c3ll256/rp-compute/product/gallery/420c5500-d6d6-4f90-9bab-eb5ddc3c4137.jpg

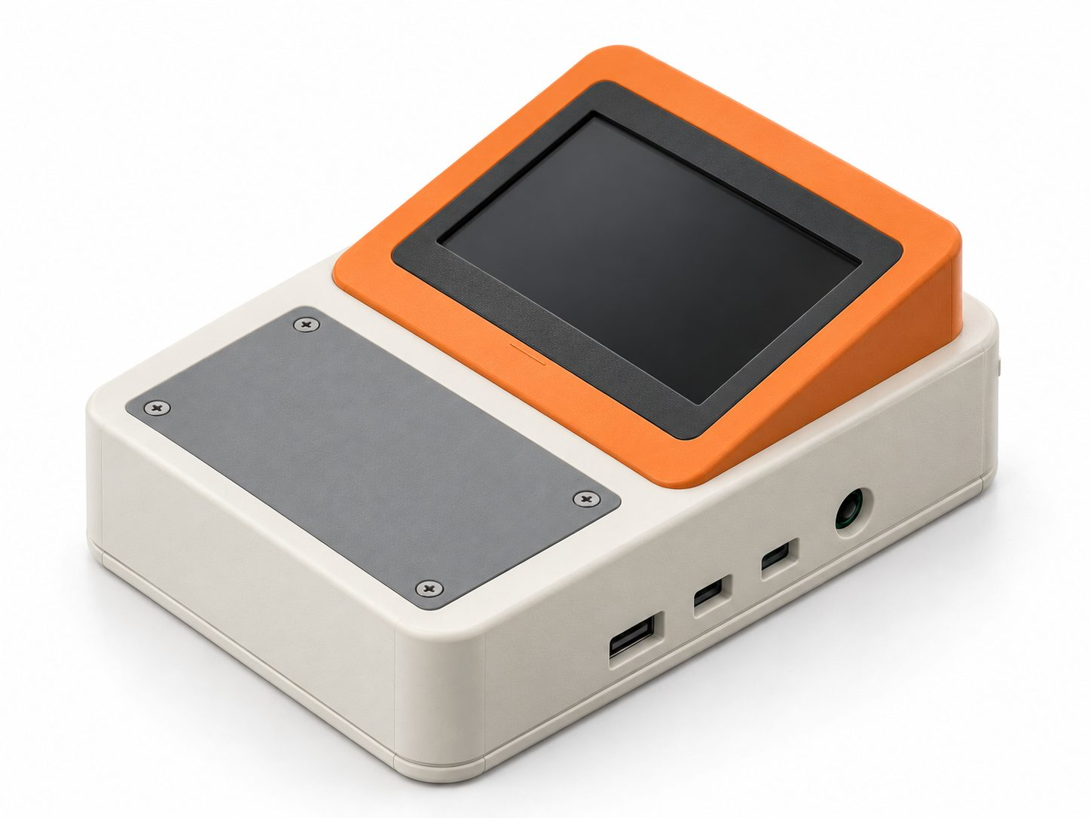
product/gallery/420c5500-d6d6-4f90-9bab-eb5ddc3c4137.jpg
