c3ll256/rp-compute/product/gallery/cover-iso.jpg

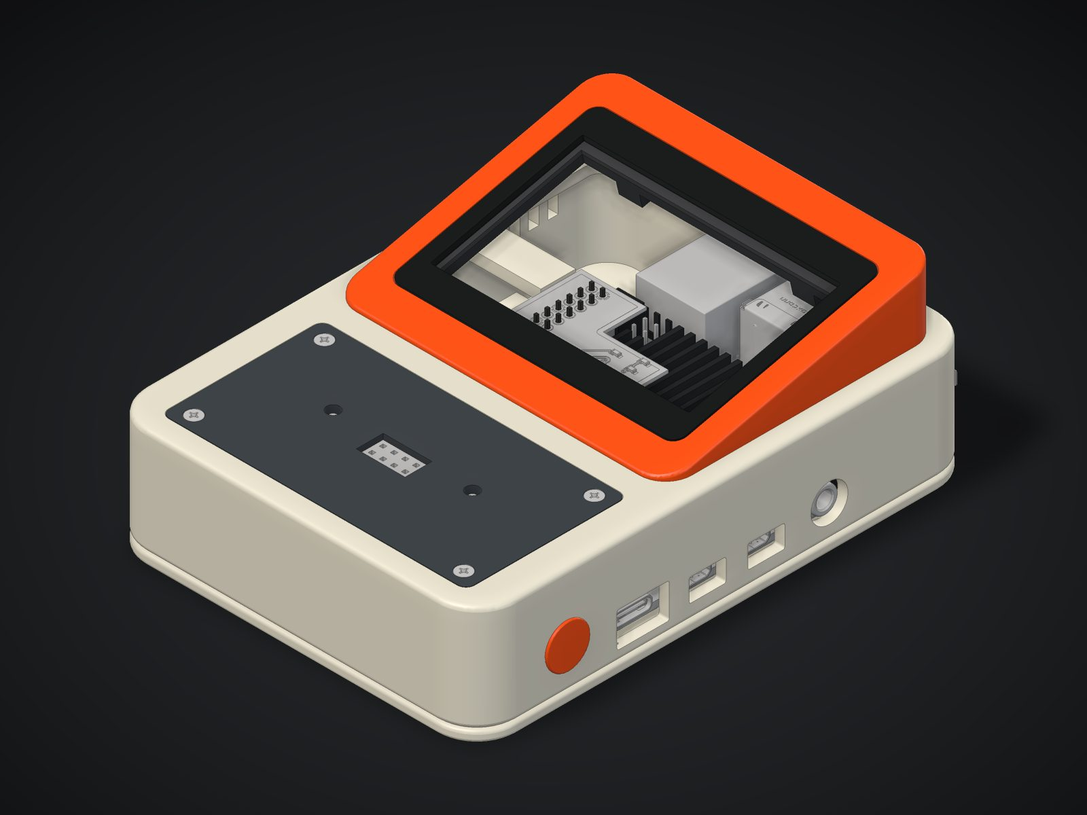
product/gallery/cover-iso.jpg
