c3ll256/rp-compute/product/README.md

# 窄边机身设计约束

## 连接器选型与薄型目标

40Pin采用用户提供商品图中的2×20通孔母座，标注塑高8mm、焊脚3.5mm、外形51×5mm；按用户提供的规格选购，不要求额外提供商品链接。未标出的针截面暂取0.64mm方针、排距2.54mm，插入深度以样机试配核对。8Pin使用2×4、2.54mm通孔直立母座，模块侧使用配套公排针，便于频繁插拔；其5mm塑高是选型默认目标。用户所发5mm图为贴片产品；通孔版本采用KiCad标准2×4、2.54mm母座孔型，1mm孔径、1.7mm焊盘。塑壳10.16×5.08×5mm、焊脚3mm为工程默认，不宣称是截图产品的原厂尺寸。模块继续用螺丝固定，拔插时支撑接口。

允许修改PCB与外壳以适配低成本连接器并减薄；不把40Pin塑高减少3.05mm等同于整机必然减薄3.05mm。Pi散热片、原生接口、排针有效插入量及屏幕FPC余量共同限制堆叠。8路模块逻辑功能保持，排距、针号方向及配套公针仍需实物规格核对。

两款连接器按已有规格和公开工程默认完成选型，采购链接、品牌和库存不作为继续设计的前置条件。PCB已换用标准通孔孔型并通过重新布线及DRC，40Pin物理针位及全部逻辑功能保持。制造文件以最新发布为准。外壳采用默认基板底面Z21.0、Pi和散热片升高1.3mm的堆叠。盖板保持平整无凸台，通孔焊脚须与后压框和壳体保持间距；连接器公差和屏幕原生短排线的最终插装需样机核对。

屏幕固定结构采用两个硬质打印件：集成玻璃定位和遮边的一体屏舱前框，以及2mm等厚后压框。取消独立内框、薄翻边、多级螺丝耳和排线护栏。保留76×59mm外轮廓、13°屏角、约1.67mm前沿和玻璃/FPC基准；66.5×49.5mm分界轮廓改为0.5mm宽、0.3mm深浅线，仍界定外侧4.75mm等宽区域。默认显示净口59.4×35.88mm、玻璃口单边余量0.3mm、正面挡边1.2mm。前/后软垫默认0.2/2mm，不计入打印件数量。四枚M2螺丝对硬止口限位，避免以玻璃承受螺丝预紧力。两件均以大平面贴床打印，PLA和0.2mm层高为试制默认；实物装配、软垫压力及打印效果需验证。

用户接受改动定制基板，以收窄屏幕边框和机身。默认机身与屏舱同步从85mm收至76mm，保持115mm机身深度、66.5×49.5mm浅分界线轮廓、13°屏面；屏幕舱正面76×59mm，上下左右四边名义宽4.75mm，前沿约1.67mm（用户已接受高度变化），后斜面约26.29°、下沿接齐机身后沿。Pi与P165-B整体左移5mm，定制基板GPIO母座跟随Pi，显示FPC座和模块座保留原基准；基板外包络默认44.5×83.5mm，前部屏幕压框螺丝位于局部X±27mm、Y=-26.25mm。40Pin和8Pin连接器按低成本通孔方案重新选型；电气功能、层数及板厚暂保持。旧PCB不能用于这组新安装位置。

# 当前散热与固定方案

采用无风扇方案，保留Pi4B、76×115mm主体、21.0mm基板安装基准，以及Geekworm P165-B单独散热器SKU100237（65×55×11mm）。删除内部风扇及专用托架、上壳接收柱、三片软垫、两颗M2×12和风扇线束。现有左侧四个通风孔默认保留为被动通风；不新增开孔。

树莓派通过平底独立托架固定在上壳。四颗ISO7046 M2.5×6沉头螺丝穿过托架和Pi原孔，旋入散热器四角M2.5金属内螺纹；托架以三颗M2×6经平耳固定上壳。底盖只负责封闭，拆底盖不拔GPIO。默认PLA、2mm侧梁、Z3mm共底面、Z5.4mm接收面，底盖平面间隙0.6mm，托架到完整底盖名义最小间隙0.4mm。保留主板、基板、玻璃和外部接口位置。

精简基板取消J_FAN风扇电源座及其专用支线，不采购或安装风扇插座和线束。Pi自身USB-C仍是供电入口。

P165-B只有厂家外形尺寸和照片，没有原厂STEP；鳍片、底部台阶、接口避让及导热贴为名义参考。实际底部接触、螺纹深度、打印装配及无风扇状态的持续负载温升须用样机验证。

# BYOP Pi 4B GPIO基板终端套件

## 当前优先版本：屏幕与 8 针 GPIO 精简基板

用户确认取消当前精简版侧面电源按钮及按钮帽，对应开孔恢复连续侧壁；关机通过系统软件完成，不新增GPIO按钮电路。

用户要求使用2.54mm、2×4通孔双排直立母座；模块侧配套公排针。Pi 自身 USB-C 为精简版唯一供电入口；外壳开放该口，取消左侧多余的基板充电开口，使风扇支撑处保持连续侧壁。精简版由 Pi 40 针 GPIO 的 5 V 触点取电，只有显示和模块支路，不向 Pi 反向供电。不含电池、充电、升压、监督 MCU 或音频。Pi 平台为 raspberrypi/raspberry-pi-4-model-b。定制 PCB 是用户明确要求的屏幕与可换模块接口基板。

8 个触点的默认分配为：1=3.3V、2=GND、3=SDA(GPIO2)、4=SCL(GPIO3)、5=MOSI(GPIO10)、6=MISO(GPIO9)、7=SCLK(GPIO11)、8=CE1(GPIO7)。屏幕占用独立 CE0；COM 改由 GPIO12、DISP 由 GPIO25、屏幕电源使能由 GPIO24 控制。SPI共享总线须由驱动协调。针距相同不代表与Pi前8针兼容。

FPC按用户最新要求采用正面水平侧插首韩0.5-10P CTSJ-H2.0 119（C5373447），扩展口采用低成本2×4通孔母座（2.54mm针距，暂按5mm塑高目标选型），移至前舱开孔中央，按数字针号保留接口功能。板外包络默认保留40×83.5mm、0.8mm厚，但扩宽中央及显示电子区以增加面积；所有实装元件在正面，背面仅Pi母座。两颗TSSOP14拉开，去耦仍靠近各自供电脚。FPC采用带详细库STEP的抽屉式上接触座；为解决窄条走线和接地回路拥堵，四层、内外1oz为本轮默认实现。布线、接地连通性和制造检查已通过，屏幕原生排线轻弯接入仍需机械核对。

扩展模块默认100mA预算，独立限流及3.3V稳压；仅断电更换，只接受本板供电的3.3V模块。显示保留必要的缓冲、去耦与受控电源。Sharp原厂规格书第11/13/14页已核对端子、逻辑电压和上下电时序；软件必须提供COM反转与关机清屏。当前紧凑板采用四层1oz、0.8mm板厚、40×83.5mm外包络；历史70×104mm两层样机板框已被取代。原生短排线仍需样板接插验证。

正面单面贴片布局的布线、制造和整机空间结果由设计发布记录报告；PCB检查不能替代实物接插、驱动和温升测试。

原 pi_baseboard 的电源完整版源文件及物料参考保留。下文电池、充电、Pi供电和联锁内容仅适用于完整版，不是当前精简版需求或采购清单；当前活动BOM只列精简版。

## 完整版历史状态（非当前精简版）
用户自带Pi4B（4GB参考默认）和兼容电池。已按“电池我自己找，继续开发”更新供货责任，停止把电池厂家选型当作基板前置条件。3.7V、3300mAh、Li-ion要求不变。

功能级BOM包含Pi和电池两项用户自备引用。GPIO插座原厂生产孔位已取得；已选定Pi/LCD独立保护支路、联锁复位/整形/锁存器件。可换前模块的连接器及线束见接口规范；单基板已有三连接器的接口位置预览，但电源/显示原理图、完整布线和电气测试仍未完成，不能作为可制造板。

电池接口见`battery-interface.md`；电源及插接设计交接见`power-interface-design.md`。实际电池充电/电流核对、最终电池仓尺寸、插接堆叠及原型测试仍需完成，不能用“用户自备”跳过。

## 已明确的需求
- 基板提供供电、屏幕和可换前平台GPIO接口；用户简单插接Pi并固定，无需焊接或逐根接GPIO跳线。不增加USB-A、Hub、固定导航键或喇叭。
- 用户确认上述屏幕、GPIO扩展、电池充电及Pi供电集成在同一块定制基板；不拆成独立功能板。
- 外壳为Pi原生接口留出开口和插头插拔空间，Pi自身USB-C除外：装机时由联锁盖防误插，拆下Pi后恢复使用。
- 用户自带Raspberry Pi 4 Model B，插入我们设计的GPIO基板；Pi本体不计入套件采购，4GB为参考默认。首版不承诺其他Pi兼容。
- 主要用途仍为 Linux 终端、SSH 和随身工具；不擅自新增桌面浏览器、视频或本地 AI 要求。
- 电池：标称 3.7 V、3300 mAh、Li-ion；用户指定容量不是整包放电能力、接头或尺寸证明。
- USB-A 外设可用电流 500 mA；USB-C 仅充电及运行供电。
- Sharp LS027B7DH01（无 A）为主选，LS027B7DH01A 为用户接受的可替代型号；每台二选一、共需一块屏幕；导航和文字输入用接在Pi原生USB上的外接键盘。
- 续航按实际情况评估，不设固定最低小时数，也不以两小时作为验收门槛；无 USB 外设轻载与有线键盘使用分别估算、实测并报告。
- 外观沿用用户两张参考图，兼顾掌上拿持和桌面放置；照片不作为内部尺寸证据。

## 公开默认值
- 用户采购兼容的单节工厂保护电池包。默认接口为电池XT30U-F／基板XT30U-M成品线束，整包持续放电选型目标至少8A；默认充电设定480mA／4.2V，必须核对实际包允许范围和容差后才启用。未知包保持禁充。
- 固定倾角、橙色一体屏框、浅色圆角主体；默认无照明、触摸、音频及铰链。用户要求屏幕凸起与机身两侧齐宽，背部按紫线做上端向前内收的斜面、下端与机身后沿齐平，不保留侧面和背面的水平台阶；机身及屏舱采用76mm宽度，屏舱后壁从竖直向前倾约26.29°，后壁下沿保持Y57.5mm，后壁名义厚度2.4mm，保持屏面13°倾角和内部安装基准。左前侧四条通风孔按用户要求采用圆角长孔，默认外包络2.4×4.5mm、端部半径1.2mm。
- 85×115×60 mm 仅为可修改排布起点，未验证 Pi 4B、完整连接器、线缆、散热及电池能装入。
- 优先使用一个 Pi 4B 原生 USB 2.0 Type-A 端口，预算 500mA；其余板载端口实体保留，不默认增加同时使用的外设功率。原 Zero 转接线及独立 USB-A 插座/限流器/数据 ESD 退出活动 BOM；不承诺原生口具有单独 500mA 硬件限流。
- 内存默认 4GB；microSD 延续 32GB A1/Class10 配件目标，具体卡未选定。
- 基板提供充电、电池管理、稳压及屏幕接口，通过40针排针的5V电源触点给Pi供电，信号保持3.3V逻辑域。外部USB-C接基板充电输入；PiUSB-C不是正常供电入口。必须设计输出限流、短路、反灌和Pi电源口硬件联锁；不再要求两路输入同时工作，不能仅靠使用警告。
- 只支持断电插拔，用机械导向防180度旋转/偏排；Pi另有独立固定，不让GPIO座单独承重。风扇接基板引出座，避免与已占用的Pi排针冲突。
- 默认只保留一枚电源/受控关机按键，归入供电功能，取消六枚导航/确认/返回按键。要求边充边用、插拔合格外部电源不重启、低电量提示与 Linux 正常关机。
- 为Pi的USB-A、网口、micro-HDMI、3.5mm接口保留可接近空间，microSD留维护通道；不新增CSI/DSI扩展。Pi自身USB-C在装机状态由联锁盖覆盖：盖打开或断线时硬件禁止GPIO供电，关盖后需主动开机，不自动重启。联锁并未测试通过；正常维护仍须先Linux关机并隔离电池。接口全露出不代表增加外设功率预算，也不新增音频功能。
- 前平台预留共用平面承托、可拆平底盖板和内部模块窗口；按接口规范设计后续GPIO功能件。只能断电更换，不宣称热插拔。

## 电量与续航边界
按用户规格计算标称能量：3.7 V × 3.3 Ah = **12.21 Wh**。不再从两小时倒推功耗上限；选型时依据实际负载与可用能量估算续航，原型阶段报告实测结果。实际可用容量、温度、老化及关机余量会降低可用能量；电源转换损耗计入电池侧负载。旧 6Ah/Zero 方案的 2.44 小时估算不能沿用。

## 硬件阶段交接
功能级选型可进入电气实现：Pi4B参考、GPIO插座、保护支路、显示接口、常开监督器与联锁逻辑已经选定。基板采用明确电气接口接收用户自备电池，不再等待电池供应商回复。元件身份和原始图片保留；退役的Zero/内部USB-C线方案不回到活动BOM。

电路阶段落实所有阻容/补偿/瞬态网络、封装与引脚连接；随后布局布线、ERC/DRC和制造导出。最终CAD适配仍需真实电池整包尺寸及完成的PCB几何；85×115×60mm不作为已验证外壳尺寸。

## 验收计划（尚未执行）
- 用户断电插入并固定自备Pi4B，由基板GPIO供电启动并驱动 LS027B7DH01 或替代型号 LS027B7DH01A 原生黑白终端；测试全部行、文字、COM反转及受控开关机。
- USB-A 识别键盘、存储设备并满足 500mA 预算；完成 Wi-Fi SSH。
- 室温 20–25°C，Wi-Fi 联网、低流量 SSH 与周期文字更新，无照明、无 USB 供电外设，测量并报告续航，不设固定最低小时数；键盘接入时另行报告。
- 充电与运行并行，电源插拔不重启；低电量受控关机，不以保护板切断作为正常关机。
- 按真实 Pi 4B 主板、散热及电池图纸检查安装与维护空间；实测热、启动峰值、压降、续航和桌面稳定性。

## 已核实的屏幕事实

LS027B7DH01 为主选，LS027B7DH01A 可二选一替代，总数量为一块。两者均保留样机验证：原生短排线长度与弯折、接触方向、完整插入和锁扣夹持、玻璃固定及软垫压力、全部行和文字、COM反转、上下电时序及实际视角可读性；资料匹配不代表样机已验证。

来源：Sharp 原厂规格书 LCY-1210401A，由 DigiKey 托管，已保存为 `product/references/LS027B7DH01-sharp-2010.pdf`。文件属于较早期规格资料，硬件选型时仍须核对实际供货版本。

- PDF 第 10 页（印刷第 7 页）：2.7 英寸、400×240、单色 Memory LCD；面板每像素 1 bit，支持串行数据及逐行更新。
- 同页：显示区 58.8×35.28 mm；模块本体 62.8×42.82×1.64 mm，尺寸明确不包括突出部分；FPC、弯折和完整外形应在硬件阶段按尺寸图复核，不能只用这个长方体做外壳。
- 同页：资料描述反射/透反射显示，可借助额外背光做透射模式，但透过率约 0.35%；本项目不默认有照明或暗处可读。
- PDF 第 11 页（印刷第 8 页）：10 个接口端子，包含 SCLK、SI、SCS、EXTCOMIN、DISP、VDDA、VDD、EXTMODE、VSS、VSSA；需要管理 COM 极性反转，不是接 HDMI 即可使用的显示器。
- PDF 第 13 页（印刷第 10 页）：VDD/VDDA 推荐 4.8–5.5 V，典型 5 V。SCLK/SI/SCS/DISP/EXTCOMIN 的 VIH 最小 2.70 V，低电平上限 VSS+0.15 V。因此不能从“5 V 电源”推出“必须用 5 V GPIO”，也不能在未检查输出低电平、时序和掉电反灌前宣称 Pi GPIO 直连已经验证。
- PDF 第 7 页（印刷第 4 页）：长时间静态图像需要刷新以减少残影风险；具体刷新和 COM 时序在驱动设计中落实。
- A 版依据 Sharp 原厂完整规格书 [LCP-1112041（2012-08-06）](https://d7rh5s3nxmpy4.cloudfront.net/CMP7377/files/LS027B7DH01A_06Aug12_Spec_LCP-1112041.pdf)，已保存为 `product/references/LS027B7DH01A-sharp-2012.pdf`。PDF第9/10/12–20/25页（印刷第7/8/10–18/23页）显示本体仍为62.8×42.82×1.64mm、有效区58.8×35.28mm；10针0.5mm间距、0.30mm厚FPC及端子定义、供电、串行协议和COM控制与主选一致。保留现有电路和名义机械基准，不据此免除实物验证。
- 光学指标按各型号分别验收：无A版PDF第24页（印刷第21页）视角CR≥2各方向最小60°、透射率约0.35%；A版PDF第23页（印刷第21页）各方向最小40°、典型水平55°/垂直60°、典型透射率0.25%。不将无A版的视角和透射率承诺沿用到A版；本项目仍无默认照明。

## Pi 4B 规格与资料边界
官方产品简介已保存为 `product/references/pi4b-product-brief.pdf`：第3页确认4GB版本、40针GPIO、microSD、两个USB2.0及两个USB3.0口；第3/5页给出5V/3A供电基准。这是供电能力要求，不是主板一直消耗15W的测量结果；原生USB负载包含在板卡供电中，不能重复加一次500mA。

第5页结构图已目视复核：参考板框85×56mm，安装孔距58×49mm、边距3.5mm、孔径2.7mm；原图明确标注近似参考尺寸，不能作为生产数据。不能据此宣称原85×115×60mm外壳已验证。内置FreeCAD模型安装时发现文件缺失；本轮改用step.parts精确Pi4B模型，校验后导入CAD。该资产许可未由供应商返回，不沿用另一文件的CC-BY标注。

原生搜索无可用条目，供应商检索返回无关器件，全部拒绝；主板以官方规格书建立身份，库存、价格及供应商SKU未知，不捏造。原有Sharp资料和器件资料保留；具体保护电池包仍未确定。

## BYOP使用边界
硬件免内部电源线不等于软件零配置；默认提供适配系统镜像/安装说明，软件尚未实现。用户自备Pi和兼容microSD系统。首版依据Pi4B验证，不能仅凭同为40针排针承诺Pi5或其他机型通用。

## 造型优先 CAD
以用户2026-09-21新增两张参考图纠正造型：低矮水平浅色底座、后方抬起的橙色斜屏舱、深色内框、前方留水平平台，不是整块缓坡机身。
本轮默认底座27mm高、屏面相对水平13°、85×115×60mm暂定包络；这些是可改的造型输入，不是照片测量值。前平台盖板在CAD和实物装配中均为独立可拆零件，取下后供用户自制拓展件沿用平面承托及四角M2固定点；盖板底面不得有定位舌或凸台。盖板外表面平整，不设GPIO直通孔、PCB螺丝避让通孔或中央凸面；盖板采用70×37×1.4mm平板，底面Z27、顶面Z28.4，只有四角沉头孔；无定位凸起或局部母座凹腔。对内部母座名义包络顶面Z26.254999的空气间隙约0.745mm，打印平整度和实物落座需试配。固定平台顶面Z27mm保持，屏舱前沿高约1.67mm，机械和电气边界见`front-module-interface.md`；不推定扬声器或固定键盘。当前精简版取消右侧电源键并封闭开孔。真实Pi参考模型及接口布局已集成；PCB、电池安装仍待集成。

屏面按用户红线压低，13°是本轮可调默认值，不是用户指定精确值；保留屏舱前沿位置/高度和65mm面长，后缘随投影加长向后移动约7.04mm。当前模型总高约约42.13mm，原60mm暂定上限不代表当前实高。

## 后方及侧面接口布局
用户要求前面无对外接口，Pi USB和RJ45留位置。当前USB/RJ45朝后，两micro-HDMI及3.5mm朝右；12×5mm基板充电开口移到左侧Y=-37、Z=12，仍待真实基板和插头核对。Pi自身USB-C保留实体遮挡，并非完成的联锁盖。microSD按断电拆底维护方案，未验证取卡手指路径。底座由20加高到27mm是容纳真实接口的默认调整，13°屏面不变。整机壳体最高约42.13mm。
已检查真实Pi参考与壳体无实体相交；插头外壳/网口卡扣、固定结构、GPIO堆叠、LCD/FPC、电池和散热尚未验证，本轮无PCB设计。

## 屏舱前沿压低
按最新红框要求，屏舱四边等宽，前沿高出平台约1.67mm，包含现有0.3mm分缝，舱体自身前沿约1.37mm；这里不是整体壁厚，圆角过渡低于名义交线。屏角13°、底座27mm、Pi和全部接口位置不变，屏幕、玻璃与FPC基准保留。屏舱后侧斜面名义交线约Z41.95mm（倒圆前）。显示屏及FPC仍未建模，压低后的内部空间不代表已适配LCD。

## 紧凑板接口

用户最新要求为水平侧插FPC 首韩0.5-10P CTSJ-H2.0 119（C5373447），允许原生排线轻弯；Pi母座采用用户选择的8mm塑高、3.5mm焊脚2×20通孔排母；扩展口改用2×4、2.54mm通孔母座。单块紧凑板、现有外壳与屏幕安装位置不变。排线暂取13.7±0.5mm，间隙每侧0.5mm，均为用户授权的默认估计，并非实测或厂商公差。布线与制造发布已经完成，装壳状态以本轮机械核对结果为准。

屏幕原生排线暂按13.7mm总长、±0.5mm估算误差继续设计，检查13.2–14.2mm两端情况；这是用户授权的默认估计，不是实测或厂商公差。总长沿排线从玻璃出线边缘量至端头，包含补强端和插入连接器的部分。排线周围按每侧0.5mm非接触间隙预留，不增加假想线长，不放宽0.45mm最小内弯半径及距玻璃0.8–6.0mm允许折弯区。无需再等待实测长度才能继续暂定布局，但最终适配仍未验证。

上外壳固定更新：用户要求紧凑板继续抬高，并固定在上外壳。当前 CAD 评估默认上抬4.3mm，板底Z21.0mm；由上外壳两处内侧横梁螺钉和后端限位承担固定，底盖及可拆模块盖不承受PCB固定载荷。GPIO母座采用用户选用的8mm塑高低成本排母；其内部接点位置和实物插入深度仍需试配；独立托架与基板安装梁使用同一新堆叠。

### 当前紧凑板接口和散热调整

用户选择低成本8mm塑高40Pin通孔排母，以及2×4、2.54mm通孔8Pin母座；外壳可重新设计，优先更薄。8Pin塑高暂取5mm为选型目标，非已核实的替换件尺寸。水平FPC入口按平面图下侧/前端-Y布局。主板底面默认Z21.0mm，Pi/散热片及其端口相对原基准升高1.3mm，仍由上壳固定。普通器件上方目标空气间隙≥1.5mm；温升、风流和屏幕原排线完整插装尚需验证。

当前FPC修订：用户确认原排线折回后露铜面朝上，授权改用水平上接触首韩0.5-10P CTSJ-H2.0 119（C5373447），保留向下/前方入口、紧凑板和上壳固定。原底接触要求由本次用户选择取代。排线总长仍按13.7±0.5mm暂估，安装尺寸须以新座的实际入口、止挡和锁扣空间复核。

FPC为代理按用户授权选择的首韩C5373447。推荐露铜≥3mm、补强≥4mm，最接近屏幕3.5/4mm端部。详细STEP来自嘉立创EDA/EasyEDA官方库（https://lceda.cn/，https://easyeda.com/）；有插槽和锁扣，但不证明实物插接公差。焊盘与原接口不同，须重新布线并核对针序及滑盖空间。

## 紧固件与打印余量

多数外壳固定点使用用户已有的M3沉头螺丝，优先匹配6、10、12mm总长。默认M3头部按90°、直径6mm的ISO10642模型留位；与头型相配的90°沉头孔增加0.4mm口径及0.2mm深度余量。板孔、散热片金属螺纹及窄小固定点保留适配的小规格。所有打印螺纹的实际装配松紧、扭矩和寿命需要试装确认。
