c3ll256/rp-compute/design/pi_baseboard_lite/README.md

# 76mm窄边机身基板

## 当前矩形基板与CAD同步

当前PCB发布69ac26497e08aced1b2858ee0777f8e5f23b9fe97a135c3ad144ca151cb584af，构建6f4d4082eaefa4fce3a78952b931d3e983881202fa64062eadc579b1e8b1da1e；裸板、装配和机械交付均ready。最终DRC为0错误、0警告、0未连接。Gerber正反面、布线正反面、In1/In2和原理图均已查看。29行JLC坐标、面别和角度已与本次编译逐一核对；TPS2553仍使用已验证供应商角度偏置，两只通孔母座仍后焊。30个过孔均0.6/0.3mm，48个连接器PTH为1mm，2个固定NPTH为2.2mm。

板框简化成43.5×68.5mm完整矩形（源X-23.5..20、Y-20.5..48），前端缩短15mm；面积3457.25→2979.75mm²，减少13.81%。无局部缺口、后端台阶或窄颈。固定孔、三只接口及器件位置沿用前次整理后的布局。普通器件焊盘外包络距板边至少4.849906mm，排线维护区保持。0.8mm四层FR4及内外1oz铜保持。

用户强调安装强度：保留两处M2固定及上壳后导轨支承，固定孔中心距32mm；孔边到板边最小2.9mm、向前6.4mm。模块接口距两孔连线仅2mm，裁掉其外侧多余悬伸板料。完整矩形保留横向连续板料。未做实际挠曲、载荷或插拔寿命测试。

CAD已绑定本发布真实装配STEP d5eedbdd2e46ee9693cc34f90c7cba7747c453ec3ba94badc9c13c7c85ab0b27，位置(-100,81,21)；后导轨跟随新左边界，普通元件凹位对应当前28个真实器件。两处螺丝承压环、上壳顶皮、普通元件空间和Pi退出路径已检查。实物FPC接插和母座接点内部仍需样机验证。

矩形板首轮全部信号接通，但U_BUF1附近两处地铜不连续；在经全层铜箔与障碍物核对的位置加入一颗0.6/0.3mm接地桥，并重新布LCD_SCLK/GPIO10，最终地铜连续且DRC通过。原被裁去板料中的LCD_LDO_GND_BRIDGE已删除；未降低任何制造规则。

以下为前一布局/发布的接口、采购与装配记录；版本号和尺寸发生冲突时以本节为准。

本板已按用户规格改用低成本通孔母座：J_PI为2×20、2.54mm、塑高8mm、焊脚3.5mm，位于背面；J_MOD为2×4、2.54mm直立母座，位于正面。8Pin塑高5mm、焊脚3mm和塑壳10.16×5.08mm为工程默认。两种孔型均来自KiCad标准库，1mm孔、1.7mm焊盘、2.54mm针距和排距；48个连接器通孔已与导出的钻孔坐标逐一核对。

布局调整前的制造发布1286ca06b0f271d5718a9a0cce4b884e21ec88652c70a55631e5a3024f2b770a的裸板、嘉立创装配和机械交付均为ready。Gerber、分开的PTH/NPTH钻孔、9行JLC BOM、29行JLC坐标和更新连接器名义外形的STEP已生成。下单规格为FR4四层、0.8mm成品厚度、内外层均1oz，层序F.Cu/In1.Cu/In2.Cu/B.Cu。

40Pin的40个Pi物理触点位置与旧版逐一比较，最大差值小于1e-6mm；换用标准母座编号后，物理Pn直接映射焊盘n，所有逻辑网络保持。J_MOD中心仍为板坐标(0,-15)，世界坐标(0,-34)，新通孔排距2.54mm取代旧贴片座焊脚跨距。其余29个器件位置、板框和安装孔保持。重建GND并重布GPIO8后，最终DRC为0错误、0逻辑未连接、0阻断警告。34个过孔均0.6/0.3mm，两个安装孔为2.2mm NPTH。无图纸框、通用件未填制造商料号、在线抓取失败及接地补救区域提示为非阻断建议，不宣称所有提示为零。

板框外包络44.5×83.5mm，左边界X-24.5mm；PCB安装孔保持(-16,-13)、(16,-13)。J_PI中心(-18.5,21)，J_LCD原点(0,24.65)，正面上接触、朝-Y；全部SMT元件位于正面。无风扇方案已移除J_FAN两针插座、封装焊盘、固定焊盘和专用5V/GND支线；不采购或后焊此座。

嘉立创代贴9种精确料号共29个器件：C5373447屏幕座×1、C404027稳压器×2、C54529缓冲器×2、C55266限流器×2，以及C14663/C377773电容和C25804/C25803/C22817电阻。4种Basic、5种Extended。型号、库分类及焊盘方向依据官方嘉立创EDA/EasyEDA记录核对；实时库存和报价未验证。证据来源https://lceda.cn/ 、https://easyeda.com/ 及https://jlcpcb.com/partdetail/TexasInstruments-TPS2553DBVR/C55266 。

review-jlc-assembly.py逐一检查精确料号、原生供应商焊盘方向、48个通孔的KiCad网络、Pi物理针位置、导出钻孔和31个发布文件哈希。J_LCD角度0°；两颗TPS2553显式JLC角度270°用于匹配供应商一脚方向，未旋转PCB焊盘。BOM/CPL的料号、位号、数量、XY、面和角度均已核对。正反面、原理图、内层局部和Gerber预览均已查看。

连接器STEP为按规格建立的名义外形参考，不是厂商内部接点或插入深度认证；标准库封装统一平移到中心原点，未改变相对孔位或编号。来源、尺寸默认和转换证据在source/models/generic-socket-provenance.json与connector-specification.json。

handheld_computer使用适配后的21.0mm基板底面、Pi/散热片升高1.3mm、8mm GPIO母座和5mm目标模块母座；盖板净空0.205mm、GPIO官方针尖基准名义插入3.885mm，通用座内部接点和原生短排线完整插装仍需试装。移除J_FAN不改变板框、孔位或其他31个器件的安装基准，装配模型同步使用本发布。

## Making and assembly

嘉立创仅代贴正面29个器件。J_PI背面2×20、8mm塑高、3.5mm焊脚通孔母座，J_MOD正面2×4、2.54mm通孔母座从JLC清单排除，按BOM规格另购并后焊；屏幕玻璃不进SMT。厂商回流后再安装这些连接器，检查0.5mm FPC座和0.65mm TSSOP连锡。必须使用同一最新发布的Gerber、JLC BOM和JLC CPL。上传嘉立创后先核对器件居中、6颗IC一脚和J_LCD朝向/接触面，返回贴装预览供检查，再付款；本地审查不代表已审核嘉立创订单。

先不装屏幕和模块，检查无短路，由Pi USB-C供电，测试受控显示电源、两路限流及FAULT。COM波形及关机时序验证后再装屏。模块仅断电更换，3.3V逻辑、默认100mA预算。

装屏时先打开屏舱取得滑盖操作空间，露铜向上插入并关闭锁扣，再固定屏舱。屏幕补强端4mm恰好达到新座推荐下限，需样板核对夹持和止挡。13.7±0.5mm原生排线总长仍是已授权估计；不得拉伸排线或放宽折弯半径。Pi堆叠公差、M2固定、实际贴装流程及热性能仍须试装。

两只母座均为通用规格件，不继承旧Samtec最小插入量。40Pin针位保持原位置，物理Pn现在直接对应焊盘n。8Pin一脚为AUX_3V3、二脚GND，随后为GPIO2/3/10/9/11/7；方焊盘标记一脚。模块固定螺丝独立承担载荷，拔插时支撑PCB。8Pin塑高5mm、焊脚3mm、塑壳10.16×5.08mm与0.64mm方针为默认，实物须匹配。
