c3ll256/rp-compute/design/pi_baseboard/README.md

# Pi 4B 单基板集成草稿

状态：单基板电路源已补入 ATtiny1616、充电 CE 许可、Pi USB-C 盖硬件联锁、跨域关机/串口、双温敏输入、UPDI、电源键、风扇及独立 GPIO 辅助电源。**本版电路编译和布局预览已通过，整板布线与 DRC 尚未通过；不是可通电或制造交付的 PCB。** 用户确认所有功能共用一块基板，扬声器不在本版范围。

## 当前几何假设

板框暂取 70 × 104 mm、1.6 mm 四层 FR-4，外层 2 oz、内层 1 oz。它是用于接口排布的边界，不是已检查的板形。以现有 CAD 世界系为放置参照：Pi 的 2×20 母座在底面 X=-13.5、Y=15.2 mm；屏幕 FH12-10S-0.5SH(55) 在底面 X=0、Y=6.7 mm；前模块 JST GHD 在顶面 X=0、Y=-34 mm。底面 FPC 候选采用 0° 放置，编译后 1 脚在 X=+2.25 mm、Y=+8.574 mm，开口向前；这与当前 CAD 参考连接器在 X 向反转后的 1 脚方向一致，仍须用实物和屏幕尾巴的背面视图逐芯核对。Pi 母座编译后 1 脚在 X=-12.23、Y=-8.93 mm；插合面上的 Pi 实际 1 脚仍须核对。JST 连接器也须用线端 1 脚和导通测试确认。

**单块刚性板的现存冲突：** CAD 中的 FPC 参考连接器绕 X 轴 -167°、绕 Z 轴 -180°，其焊接平面相对水平 Pi 插接平面倾斜约 13°。PCB 工具只能把这只标准 FH12 焊在平面板上，因此现有斜置 CAD 连接器目标不能直接作为该刚性板的落点。下一版需要保留玻璃定位槽、背面夹持和屏舱前沿高差 1 mm，同时重新核定水平连接器与原生短 FPC 的折线、插入长度、锁扣操作空间，以及板的 Z 高度。原生尾长 13.7 mm 是图纸比例估计，不是有公差的实测尺寸。若它无法到达水平单板，必须重新选择单板工艺或改变经用户确认的接口方案，不能靠拉紧尾巴或虚构延长长度来闭合。

目前板框尚未和壳体上壁、Pi 散热器/USB 端口、前平台通孔、电池仓、左侧充电口以及螺钉柱逐实体比对。板顶、板底的元件禁布区和固定孔尚未定义；70 × 104 mm 不作为生产尺寸。前平台的机械窗口仍为 54 × 26 mm，JST 插头和线束应能由此维修，线束应有独立夹持且不能让 JST 焊脚承受模块力。

## 电路完成条件

LCD 的 EXTMODE 接到开关后 VDD，SCLK/SI/SCS 由 Pi SPI 经 SN74AHC125 缓冲，DISP 与 COM 已接 MCU PC0/PA5。监督器通过 PB1/PB0 控制 BQ25622，PC1 经开漏缓冲控制 CE；默认上拉禁充。PB5 经开漏缓冲清零主供电锁存，PB4 经施密特门发 ARM，开盖独立硬件复位。完整引脚与失效状态见 controller-contract.md。固件尚未实现，不把这些连接当作经过验证的功能。

GPIO AUX_3V3 已有独立源：主 5 V → TPS2553DBVR → TLV75533。Pi 3.3 V 仅作使能，正常模块预算 100 mA，169 kΩ ILIM 电阻给出约 136–187 mA 限流角落。故障接 Pi GPIO25/物理22。信号线仍缺完整 ESD 与掉电/过流反灌隔离，不支持带外部电源的模块或热插拔。

2026-09-24 已排除先前编译超时：新增控制芯片采用与原厂封装一致的 KiCad 标准库，保留准确 MPN 和供应商身份。辅助电源两处阻容已移出温敏线接口的应力释放区域。最新 preview 成功、无布局错误；顶面、底面及分组原理图已人工查看。此项仅验证电路编译和初步布置，不代表布线、机构适配或制造就绪。

本轮保留 TPS22990 pin 10 矩形/多边形共用 V5_MAIN 逻辑端口的修复，未改动器件身份、固定接口、CAD 或电流/线宽/逃线长度要求。调整充电和升压电感、输入/输出电容的位置与方向，形成 39 处源文件声明的局部电源铜区。充电端 BAT/SYS 分别扇出；升压 SW 并联脚朝向电感，三个输出电容旋转后共用输出铜区。所有铜区轮廓有效，最终没有元件重叠、短路、铜间距或热连接错误。

六个细脚电源网 USB_VBUS、CHG_VBUS、BAT_RAW、SYS_RAW、CHG_SW、CHG_PMID 的铜区间距从默认 0.25 mm 改为制造规则已有的 0.15 mm 下限，使 BQ25622/TUSB320 细脚颈部不被填铜清除；这一变化作用于这些网络，未改动制造能力、目标电流、任何线宽、或最长 1 mm 的逃线限制。所有 9 个带 currentCapacity 的网络不再因细焊盘压低全网布线宽度，DSN 恢复 1.2 mm 或 2 mm。**这是布线输入规则恢复，不是已经生成了完整的宽干线，也不是载流合格。**

最终完整检查 run `37241952-a874-411b-a105-8bc95fac9e7c` 仍 blocked。工具有 3 条聚合错误诊断；原始 KiCad 为 46 项未连通，应用归并为 40 项连通阻断（含 6 个分裂铜区）。独立 KiCad 检查对同一板得到相同 46 项未连通和 144 条库封装元数据警告，实体几何错误为 0；使用 `--exit-code-violations` 返回 5，DRC 未通过。USB_OUT2 定向重布后已无原始未连通项。升压 V5_BOOST 虽已退出自动布线的未完成网摘要，KiCad 仍报告其铜区内部 2 处断裂，不能宣称该电源完整连通。

实际铜线统计：BAT_RAW、SYS_RAW、USB_VBUS、CHG_VBUS、BOOST_SW、V5_MAIN 没有干线线段，V5_PI 只有 1 段 1.2 mm 线；CHG_SW、V5_BOOST 使用铜区，但仍须检查填铜后的分支和断裂。部分信号穿过功率铜区，造成颈部收缩或分裂。因此本轮原始未连通项多于旧细线版本；不能用“3 条错误”或零实体错误代替连通验收。

已定位新的运行时接口缺口：源铜区在最终 KiCad 中存在，且宽度策略识别其覆盖的功率焊盘；但全量布线 DSN 的 wiring 没有这些铜区几何，仍以原始细脚为端点。定向重布 DSN 保留了 933 条普通走线，却同样没有功率铜区 polygon。大电流网缺失干线、信号切开铜区的情况在定向重布后仍存在。须让自动布线输入携带实际铜区连通和可接入边界，再完成电源干线、地铜连通及局部瓶颈检查；不能通过降低电流、线宽或修改生成物放行。复现证据见 routing-blockers.md。

最终板 SHA-256 为 `fd11b4bc419043440250154f29b934e2d769121b67f37c89857c3983f19ee064`。已查看该最终板的顶/底铜层；主开关输出、电源支路和地铜仍有断点。原先 17 个有位置依据的地过孔保留，当前已不再出现旧版 14 条过孔间距误判。未运行制造 release。

尚需确定所有功率阻容的实际型号，完成固件、充电复位、外部电源切换、温升和低电量关机测试。加入模块预算后的 5.1 V/3.3 A 及约 5.80 A 电池侧仅为条件计算。固定孔、禁布区和 FPC 机械到达性尚未闭合。当前不发布制造文件。

## Making and assembly

目前没有可下单或可通电的板。Pi、屏幕和模块只能冷插拔；更换模块前断开外部 USB-C、停机并隔离电池。实物板首次接电之前逐芯核对屏幕 FPC、Pi 40 针、JST 线端以及电池导线正负极；本版板上仅为焊线焊盘，非 XT30 本体。先用限流实验电源验证电源链和联锁，再装用户自备的有保护电池。不得使用当前布局草稿制作或装配功能机。
