c3ll256/rp-compute/product/compact-enclosure-proposal.md

# 窄边框与机身缩小方案

用户目标：收窄屏幕边框，并据此缩小机身；保留后壁向前倾斜的造型、圆角通风孔和便于竖直装配的结构。

## 已读取的尺寸

基于当前CAD构建de901731b4cbe1d8c959d7c0e5c848532e95c80f52df707657bd4504d826f3e0：机身与屏舱宽85mm，屏舱内框开口66.5mm、有效显示宽58.8mm。正面外框侧边名义宽(85-66.5)/2=9.25mm。Pi实际参照包络X=-17..41.5mm，风扇托架X=-39.8..-20.4mm；不能只按屏幕宽度等比例缩壳。

## 已授权方案（尺寸为代理默认）

用户已确认接受改板，采用机身与屏舱等宽76mm作为本轮目标。保持66.5mm内框开口时，外框侧边降为4.75mm，约减少49%。屏幕及排线连接器尽量保留原基准，保留13°屏面；屏舱正面收至76×59mm，四边等宽4.75mm，用户接受前沿约1.67mm，后壁从竖直向前倾约26.29°且后脚与机身齐平。

为释放横向空间，试排Pi与散热片整体沿X左移5mm、风扇沿X右移3mm、沿Y前移3mm。GPIO插座必须跟随Pi移动，而显示FPC座应保留屏幕基准，因此需要重排定制pi_baseboard_lite基板的GPIO母座、相关板框、走线和固定让位；现有PCB不能宣称直接兼容此布局。所选Pi、显示屏、散热片、风扇型号不变，紧固点及接口开口随后随实际布局调整。

76mm是首个布局目标，不是已通过干涉或打印检查的保证尺寸。实施前需确定是否接受改变现有PCB；若接受，需先完成PCB布局、布线和制造检查，再使用该版真实板模型完成外壳、装配及导出检查。若保留现有PCB，缩窄幅度受目前排布限制，不能承诺76mm机身。

## 授权与验证

用户2026-10-17明确接受改板，不再保留是否改板的待选项。新版基板已完成布线、零错误/零警告DRC和制造/机械集成发布，外壳已基于真实板模型重建为76mm宽；前部压框连接筋收至4mm并通过Pi/上壳、Pi/底盖、PCB/上壳、PCB/屏舱、PCB/压框逐实体零共享体积检查。风扇与散热片2.5mm、托架与散热片0.7mm。最终STEP由CADhandoff导出，本说明不是模型文件；尚未实物打印、GPIO插拔、排线插接或温升测试。
