c3ll256/rp-compute/product/HARDWARE.md

# BYOP / BYOB Pi4B：功能级硬件交接

## 状态
用户自备Pi4B和兼容电池，基板仅扩展电源管理及Sharp LS027B7DH01，无新增USB-A、Hub、导航按键或内部Pi USB-C线。日常只用基板充电口；Pi自身USB-C在装机时由防误插联锁盖覆盖。

28行功能级BOM可交给原理图/PCB设计，包含Pi和电池两项外部自备引用，不是28种可直接下单的SMT料。电池不编造型号或额定值；采购条件见battery-interface.md。`bom_ready=true`不等于制造、实物兼容或电气验证通过。

## 新落实的选择
- 保留Samtec SSQ-120-02-G-D，取得原厂生产图和PCB孔位：2×20、2.54mm、1.02mm孔径。没有把壳高8.51mm当成固定柱高度。
- 保留TPS22990与Pi支路TPS259470LRPWR；增加另一颗相同保护器件为LCD独立支路。给出LCD静态OVLO分压和容差验算，但动态过冲仍需电路分析/测试。
- 联锁新增SN74LVC1G74DCUR锁存、TPS3808G33DBVR复位、SN74LVC2G17DCKR施密特整形。D2F-01L只作控制接点，不承载Pi电流；开盖清零，关盖不自动重启。
- 用户自备电池按1S 3.7V3300mAh工厂保护整包、XT30U-F成品线束接口设计。≥8A为默认整包选型目标，不提高BQ25622的6A连续通路限制。充电目标改为芯片可编程的480mA／4.2V，实际包及温度监测未核对时禁充。

## 详细设计输入
- `battery-interface.md`：电池购买兼容条件、首次连接和电池仓边界。
- `power-interface-design.md`：联锁连接意图/状态表、Pi压降预算、LCD静态OVLO、GPIO孔位、后续实现验收。
- `constraints.json`：机器可读活动约束；所有superseded字段只是历史来源，不是当前有效要求。
- `hardware-evidence.json`：原厂资料、供应商身份及文件哈希。

## 保持不变
Pi支路3A包括原生USB外设500mA与暂定风扇100mA，不重复计数；LCD/逻辑100mA及100mA余量，总5.1V／3.2A条件设计目标。SYS≥3.5V、效率≥85%、AON30mA时电池通路计算5.6254A；热、低电压及瞬态未验证。5V3A输入不保证满载同时充电或无电池运行。

屏幕保持无A后缀DH01，FH12-10S-0.5SH(55)底触点和平直尾排线方向；不将屏幕5V供电解释成5V GPIO逻辑。COM反转和关机时序由监督器/软件实现，尚未实现。

PI4-FAN-PWM无FAN Adapter保留，风扇引线接基板，不再插被占用的Pi排针。单电源/受控关机按钮保留。原生其他接口留出，microSD可维护。

## 下阶段必须完成，不是已验证结果
原理图完整阻容与保护网络、功率故障预算、引脚资源、封装绑定，随后PCB布局、布线、ERC/DRC和导出。真实电池整包外形/出线决定最终电池仓；真实Pi排针、插座与散热器决定固定柱堆叠。首次充电、开盖断电/放电先后、无自动重启、接点粘连、低电量关机、热及插拔电源不重启均须验收。此时不应直接生产整机。

不再用“找不到电池型号”阻塞板侧设计，也不假称自备电池已经通过兼容检查。没有开展PCB/CAD，没有续航实测或功能安全认证。
