c3ll256/rp-compute/design/pi_baseboard_lite/implementation.md

# 电路、接口和证据

## 资料

Pi索引身份：raspberrypi/raspberry-pi-4-model-b。[官方GPIO图](https://raw.githubusercontent.com/raspberrypi/documentation/master/documentation/asciidoc/computers/raspberry-pi/images/GPIO-Pinout-Diagram-2.png)已目视核对，SHA256 646c2db09e9eb5894440b22c9fe1b9623dfd4ecefcf3aaae7f554e5fd8c1c934。5V使用物理2/4脚；1/17脚仅提供控制参考/故障上拉。GND为6/9/14/20/25/30/34/39，17个未用Pi端子明确留空。

Sharp资料：product/references/LS027B7DH01-sharp-2010.pdf，SHA256 997ecbcb7f020fbe077632dc90f6bf82d9e0e49ccf2211484093dec348965d98。第11页端子，第13页电平，第14页上下电，第15页串行与COM时序。FPC座首韩0.5-10P CTSJ-H2.0 119/C5373447，采用其精确供应商封装，本版装在正面，保持屏幕信号功能及向-Y开口，插座针号按折回装配映射。

TI原厂资料：[TPS2553](https://www.ti.com/lit/ds/symlink/tps2553.pdf)、[TLV755P](https://www.ti.com/lit/ds/symlink/tlv755p.pdf)、[SN74AHC125](https://www.ti.com/lit/ds/symlink/sn74ahc125.pdf)。复用已核对DBV/PW封装及引脚。TPS2553采用KiCad SOT-23-6，1=IN、2=GND、3=EN、4=FAULT_N、5=ILIM、6=OUT。TLV75533为1=IN、2=GND、3=EN、4=NC、5=OUT。

当前母座：Pi座为Samtec ESQ-120-12-G-D，2×20、2.54mm间距、11.05mm壳高、2.29mm焊尾，原厂资料https://suddendocs.samtec.com/catalog_english/esq_th.pdf。扩展座为Samtec HLE-104-02-G-DV，2×4、2.54mm配合间距、3.66mm壳高、正面SMT，原厂资料https://suddendocs.samtec.com/catalog_english/hle.pdf。HLE焊盘行距5.05mm，不得用普通通孔母座替代。SSQ-104历史高母座已不是活动BOM的扩展接口。Pi物理针序和扩展口1–8映射保持原已核定设计；实物插合和壳体适配仍需样机验证。

## 显示端子映射

| 屏幕端子（非座端子编号） | Sharp信号 | 本板网络 / Pi来源 |
|---|---|---|
| 1 | SCLK | LCD_SCLK，GPIO11物理23，经缓冲 |
| 2 | SI | LCD_SI，GPIO10物理19，经缓冲 |
| 3 | SCS | LCD_SCS，GPIO8物理24，经缓冲，高有效 |
| 4 | EXTCOMIN | LCD_COM，GPIO12物理32，经缓冲 |
| 5 | DISP | LCD_DISP，GPIO25物理22，经缓冲 |
| 6/7/8 | VDDA / VDD / EXTMODE | 共同V5_LCD，外部COM模式 |
| 9/10 | VSS / VSSA | GND |

AHC125由显示支路生成的3.3V供电。Sharp VIL上限0.15V；AHC小负载DC VOL上限0.1V，动态电平和边沿仍须在实际FPC末端测量。Pi侧五路各100k下拉。未用缓冲输入接地、使能拉高、输出留空；DISP无拖慢边沿的对地电容。

## 电源

Pi原生USB-C唯一输入。显示EN为GPIO24/物理18并以100k默认关闭；模块EN为Pi3.3V并带100k下拉。显示5V供LCD及缓冲LDO，模块5V供模块LDO，两路5V各10k泄放。FAULT开漏并联，由10k上拉到Pi3.3V，送GPIO16/物理36，只能报告任一路故障。

169kΩ±1%设置TPS2553，原厂上下界约136–187mA。模块正常预算100mA；LDO在5.25V、100mA时约耗散0.195W，样板需测温。2.2µF/50V/X5R/0805为CL21A225KBQNNNE，偏压后有效容量和LDO稳定性仍须实物核对，不能以额定电压代替容量证据。

外层1oz、10°C温升IPC-2221估算：0.5A约0.115mm、0.2A约0.033mm，设计电流下限统一至少0.20mm。实际输入/模块干线0.5mm，显示5V全网0.25mm，缓冲电源0.30mm。FPC采用0.15mm铜间隙；未通过降低电流预算解决DRC。当前为四层、内外1oz、0.8mm厚；GND铺铜位于F.Cu、In1.Cu和B.Cu。四个源声明的桥接过孔及其他布线过孔共39个，全部0.6/0.3mm，无via-in-pad例外。

## 驱动约束（尚未实现）

1. 启动先令GPIO24和五路显示信号低；开启电源并稳定后按Sharp第14页清显存、使能DISP及COM，上电T3/T4各至少30µs。完整顺序以图纸为准。
2. SPI不超过2MHz，按Sharp位序和行协议；SCS高有效，不能直接使用Linux默认低有效CE0。模块CE1独立，共享总线只选中一方并切换对应速率/模式，空闲MISO高阻。
3. GPIO12硬件PWM持续产生COM输入。外部输入1–20Hz，COM反转对应0.5–10Hz，默认初试2Hz外部输入，实测后冻结。没有独立硬件COM看门狗，驱动退出/停机必须关闭显示电源。
4. 正常关机按Sharp时序清屏、DISP拉低并等待，再关GPIO24。异常拔USB-C的掉电顺序没有验证。
5. I²C使用Pi既有上拉，模块不得拉到5V，额外上拉须核算总阻值。扩展口只允许本板供电、3.3V逻辑、断电插拔。

## 未验证边界

检查通过不证明波形、COM持续性、5V压降、温升和模拟稳定性。电气类型元数据和24个NC声明已进入编译电路及原生原理图；当前完整原生ERC为0错误、447条警告，原生原理图/PCB逐网络一致。Pi冗余电源触点不再被声明为独立电源，缓冲器的功能引脚排列修复了接地输入识别。详细证据见electrical-export-issue.md及electrical-review.json。装机需打开Pi USB-C，核实GPIO堆叠、连接器/散热器避让、支柱孔位、完整短FPC路径及锁扣操作。不得将本电气样板直接当作整机已验证安装板。

当前FPC为首韩C5373447上接触抽屉式；厂家图纸及供应商封装/模型证据见接口比较记录。入口-Y，源(0,24.65)，保留座端子=11−屏幕端子。座1..10对应VSSA,VSS,EXTMODE,VDD,VDDA,DISP,EXTCOMIN,SCS,SI,SCLK；5V接3/4/5，GND接1/2。

原始库模型c_origin相对封装为Y=-1.2800076mm，STEP最低Z=-1mm；转换封装铜中心重定位+0.35mm，因此显式模型平移Y=-0.9300076/Z=+1使落座面为Z0并对齐实际焊盘。源STEP哈希504b9584227db6e9942faceadb3f6e21c08d76d2b1e142ccfa9dea79109cca87。模型是库详细实体，不认证实物插接公差。

扩宽板面，所有元件正面，仅J_PI背面。原来狭窄区域的接地桥接位置已随布局改变失效；保留未改变GPIO区桥接，并依据实际顶层GND孤岛与内层GND重叠处增补源坐标(2.8178,17.822197)接地过孔，最终没有未连接网络。最终新增LCD稳压器GND和Pi26内层GND岛的各一枚有填铜几何证据的桥接过孔；过孔全部维持0.6/0.3mm，铜边1mm，不放宽制造下限。LCD稳压器转180°并调整两颗电容，缓冲器1与旁路电容整体右移2mm；电气网络未改变。
