c3ll256/rp-compute/design/pi_baseboard_lite/fpc-connector-comparison.md

# 屏幕 FPC 接口候选比较

2026-10-02。用户授权代选后，采用首韩 C5373447 / 0.5-10P CTSJ-H2.0 119，并已同步精确封装、引脚与真实库STEP，完成重新布线。下面保留替换前的候选比较基准。

优先建议考虑首韩 **C5373447 / 0.5-10P CTSJ-H2.0 119**：它绑定可用 STEP，接触方向和端部推荐尺寸最接近现有屏幕。它不是原封装的直接替代，且锁扣从翻盖式改为抽屉式；实物插接和装配空间仍需验证。

## 比较基准

- 屏幕为 Sharp LS027B7DH01。屏幕图纸 PDF 第 26 页（印刷页 23）给出排线宽 5.5±0.05 mm、10 针、0.5±0.02 mm 间距、厚 0.3±0.03 mm、露铜段 3.5 mm、PI 补强段 4.0 mm。
- 已确认安装方式为排线向后回折、露铜朝上，接口入口朝 PCB 源坐标 -Y。因此需要上接触；从 PCB 顶面看、入口朝 -Y 时，接口 1 脚在左。屏幕端子与接口端子的对应关系保持 `socket_terminal = 11 - panel_terminal`。
- 原 C5139870 采用翻盖式锁扣。现有 CAD 是 9.5×6.2×2.0 mm 的图纸外形参考包络，内部插槽未建模。其嘉立创库数据没有绑定 3D 模型。供应商文案误标下接；[Hirose 精确型号页面](https://www.hirose.com/en/product/p/CL0586-0550-9-55)和厂家图纸确认 FH12A 为上接触。
- 以下尺寸为下载 STEP 的闭合状态外接框实测，不能替代厂家公差或锁扣打开后的操作空间。

## 候选结果

三款均为上接触、10 针、0.5 mm 间距、适配 0.3 mm 排线，厂家标称板上高度均约 2 mm。均为嘉立创 SMT 扩展库；搜索未返回满足条件的基础库选项。价格及库存是本次查询快照。

| 嘉立创料号 / 精确型号 | STEP 宽×深×高，mm | 推荐排线露铜 / 补强长度 | 入口朝 -Y 时的 1 脚 | 单件价 / 库存 | 判断 |
| --- | --- | --- | --- | --- | --- |
| [C5373447，首韩 0.5-10P CTSJ-H2.0 119](https://item.szlcsc.com/6227364.html) | 10.60×5.30×2.010 | ≥3.0 / ≥4.0 mm | 原生 0°，左侧 | ¥0.547 / 1,835 | 优先候选；屏幕名义端部尺寸满足推荐下限 |
| [C588226，Molex 527451097](https://item.szlcsc.com/615997.html) | 11.10×5.00×1.905 | 4.0±0.5 / 6.0±0.5 mm | 原生 0°，左侧 | ¥4.29 / 1,635 | 屏幕 4 mm 补强段不满足推荐长度，暂不建议直接用于现有屏幕 |
| [C262583，钜硕 AFC07-S10ECA-00](https://item.szlcsc.com/253892.html) | 10.60×5.20×2.000 | ≥3.0 / 6.0 mm | 原生需转 180°，转后左侧 | ¥0.669 / 29,174 | 屏幕 4 mm 补强段与推荐长度不同，兼容性未建立 |

首韩比原参考包络宽 1.1 mm，左右各增加约 0.55 mm。其屏幕补强段 4.0 mm 恰好达到推荐最小值，不能据此保证实际夹持可靠。首韩图纸侧剖给出 4–34 针型打开状态约 6.7 mm 的参考尺寸；后续布局须核对抽屉拉出操作空间。Molex 图纸给出锁扣行程 1.4 mm。钜硕图纸中 5.2 / 6.15 mm 的侧向尺寸含义需进一步确认，不能拿闭合 STEP 来证明完整动作空间。

## 引脚与焊盘

读取每款供应商原始封装并按目标入口旋转后，已确认 1–10 脚齐全、间距 0.5 mm、1 脚在左。以上旋转针对原始嘉立创库坐标；转换成 PCB 封装后仍须核对坐标变换，不能只复制旋转角。

| 型号 | 信号焊盘，mm | 信号行相对原点 Y，mm | 固定焊盘中心 X / Y，mm | 固定焊盘，mm |
| --- | --- | --- | --- | --- |
| 原 FH12A | 0.30×1.30 | +1.625 | ±4.150 / -1.625 | 1.80×2.20 |
| 首韩 C5373447 | 0.30×1.80 | +0.950 | ±4.200 / -0.950 | 2.50×3.20 |
| Molex C588226 | 0.30×0.80 | +0.963 | ±4.700 / -0.963 | 2.40×3.05 |
| 钜硕 C262583，转后 | 0.30×1.20 | +1.085 | ±3.850 / -1.085 | 2.20×3.30 |

三款都不能沿用原焊盘。信号端子对应关系可以保持，但需要换精确封装，按实际插口定位，重新布线，并检查屏幕排线插接、板边距离及外壳中的滑盖空间。原点对齐的焊盘叠图仅用于展示差异，不代表插口或装配基准已对齐。

## 3D 模型验证

实际下载并导入了三款绑定的 STEP，均为有效几何；渲染可见插槽、锁扣和触点结构，已测量尺寸并记录 SHA256。首韩模型有 5 个实体 / 516 个面；Molex 为 1 个合并实体 / 558 个面；钜硕有 4 个实体 / 783 个面。

模型来源为 **嘉立创EDA / EasyEDA 官方库**（[嘉立创EDA](https://lceda.cn/)、[EasyEDA](https://easyeda.com/)），不是厂家认证装配公差模型。钜硕绑定的是通用库模型 `FPC-SMD_P0.50-10P_LCS-SJ-H2.0`，应额外核对具体锁扣变体。首韩 STEP 原始 Z 范围为 -1.0 至 +1.01 mm；安装到 PCB 时必须核对落座平面，不能直接按原始坐标零偏移绑定。

## 证据与交付边界

- 首韩：[供应商图纸](https://atta.szlcsc.com//upload/public/pdf/source/20230321/8BA0DE4D38BE66CF3C031935900E1E28.pdf)，PDF 第 1 页；[精确库绑定](https://easyeda.com/api/products/C5373447/components)。
- Molex：[厂家图纸](https://www.molex.com/content/dam/molex/molex-dot-com/products/automated/en-us/salesdrawingpdf/527/52745/527451097_sd.pdf)，PDF 第 1–2 页；[精确库绑定](https://easyeda.com/api/products/C588226/components)。
- 钜硕：[供应商图纸](https://atta.szlcsc.com//upload/public/pdf/source/20190726/C11082_A2E7B12387019CE4314BB5199EE0FDF4.pdf)，PDF 第 1 页，型号编码 E 明确为上接；[精确库绑定](https://easyeda.com/api/products/C262583/components)。
- 屏幕端部依据项目已有 Sharp 原始图纸；该图纸已逐页视觉检查。本次没有改动屏幕安装需求。
- `fpc-candidate-geometry.json` 记录封装坐标、模型来源与哈希；`fpc-candidate-models.png` 展示下载模型和焊盘叠图；`inspect-fpc-candidates.py` 可重新生成几何证据。

首韩 C5373447 已替换原 FH12A。当前编译、全连接、DRC及DFM通过；正面31个元件，背面仅Pi母座。库模型与封装原点校准已验证；具体实物排线夹持仍需样板试装。
