c3ll256/rp-compute/design/pi_baseboard/controller-contract.md

# 单基板监督器、充电许可和模块辅助供电

本文件对应已编译的电路连接，不代表 DRC 或样机测试通过。2026-09-24 新增电路已通过编译与布局预览；完整布线检查仍有阻断，结果见 README.md 和 routing-blockers.md。固件尚未编写和烧录。

## ATtiny1616-SN 引脚分配

依据 Microchip DS40002204A 第 15、18、505–506 页，采用 SOIC-20 的物理脚号；内部时钟目标 5 MHz。PA0 保留 UPDI，不改为普通 GPIO。编程口的 AON 引脚为目标电压参考，禁止编程器与板上电源相互供电。

| 物理脚 | 端口 | 网络和作用 |
| --- | --- | --- |
| 1 / 20 | VDD / GND | 常开 3.3 V / 地，100 nF 和 1 µF 去耦 |
| 2 | PA4 | BAT_ADC，电池电压 100 kΩ / 100 kΩ 分压 |
| 3 | PA5 | MCU_COM，TCB0 默认输出位置，屏幕 COM 反转 |
| 4 | PA6 | SYS_ADC，SYS 电压 100 kΩ / 100 kΩ 分压 |
| 5 | PA7 | NTC_ADC，独立 103AT-2，10 kΩ 上拉 |
| 6 | PB5 | MCU_RUN_OK，低电平经开漏缓冲清零主电源锁存 |
| 7 | PB4 | MCU_ARM，经施密特门驱动锁存 CLK |
| 8 / 9 | PB3 / PB2 | MCU_RX / MCU_TX，默认 UART |
| 10 / 11 | PB1 / PB0 | CHG_SDA / CHG_SCL，默认 TWI |
| 12 | PC0 | MCU_DISP，屏幕使能，已有外部下拉 |
| 13 | PC1 | MCU_CHG_DISABLE，高电平禁止充电 |
| 14 | PC2 | POWER_KEY_N，独立电源键，10 kΩ / 10 nF |
| 15 | PC3 | BOOST_EN，升压使能，已有外部下拉 |
| 16 | PA0 | UPDI |
| 17 / 18 | PA1 / PA2 | MCU_REQ_N / MCU_ACK_N，Linux 关机握手 |
| 19 | PA3 | ILK_RESET_N，读回盖联锁/电源复位总线 |

BAT/SYS 分压器输出阻抗约 50 kΩ，100 nF 储能电容时间常数约 5 ms；固件须等待稳定并满足 ADC 采样时间，校准基准及电阻误差。电池最高充电电压分压后约 2.1 V；还须验证 AON 掉电时的注入电流。NTC 开路接近 AON、短路接近地，两者均作为禁充故障，不能当作有效温度。

## 默认状态与状态机约束

- MCU 复位/未烧录：RUN_OK、ARM、BOOST_EN、DISP、COM 外部下拉；CHG_DISABLE 外部上拉。主电源关闭，CE 经 SYS 上拉保持禁充。此处是静态逻辑核对，尚未验证电源斜坡和毛刺。
- 上电初始化先把输出寄存器写为上述禁止状态，再切换引脚方向；开启 MCU 欠压检测和看门狗。看门狗复位后输出回到高阻，由外部电阻恢复禁止状态，随后必须重新收到电源键动作。
- RUN_OK 从低变高只释放开漏复位；盖关闭且 AON 有效后，TPS3808 延迟释放。ARM 必须保持低，等待复位释放和锁存恢复时间，再响应一次新的按键发上升沿。关闭盖子本身不会重新开机。
- 开盖或线断：MR 被 1 kΩ 拉低，经 TPS3808、施密特门异步清零锁存，TPS22990 关闭；不依赖 Linux 或 MCU 轮询。正常维护仍应先完成 Linux 关机。机构须保证先断电和放电，后允许接入 Pi 原生 USB-C。
- 正常关机：请求 Pi 关机，收到协议定义的完成信号后，按屏幕原厂时序停止显示并清零 RUN_OK，随后关闭升压。不能把串口停止输出当作关机完成。
- CHG_INT 当前只上拉，未占用 MCU 引脚；固件通过 TWI 轮询状态和故障。PG/STAT 不作为隐含的硬件充电许可。

## 充电许可

SN74LVC1G07 开漏输出拉低 BQ25622 CE 才允许充电；它的输入 CHG_DISABLE 默认为高，输出释放时 CE 由 SYS 拉高。该许可与主电源锁存独立，因此主机关机时仍可在符合电池条件后充电。

每次启动、I²C 失败、充电器复位或配置失配，先保持 CE 高。取得兼容保护电池的有效配置并确认双温敏无故障后，写入并读回 4.2 V、480 mA（80 mA 步进的 6 档）及输入电流、保护和定时器设置，再拉低 CE。默认充电温区为 5–40°C，且不得超出实际电池厂家范围。电池资料未知时维持禁充。

TI SLUSEG2D 第 42 页规定：上电/寄存器复位的 ICHG 是 1040 mA；看门狗超时则把先前 ICHG 减半并向下取整，二者不能混淆。第 49 页规定看门狗默认 50 s，EN_CHG 会在看门狗超时后恢复允许。因此**寄存器 EN_CHG 不是唯一禁充手段**，外部 CE 必须保留。MCU 看门狗与充电器看门狗的具体服务周期、寄存器 POR 检测和复位瞬态仍须在固件及样机验证中闭合。

## Pi 域和模块电源

四个 SN74LVC1G07 跨域缓冲分别处理 UART 双向和关机握手双向，输出上拉只接接收端电源。Pi 物理 8/10 为 TX/RX，11/13 为请求/应答，32 为风扇 PWM；依据 Raspberry Pi 官方 GPIO 图。串口速率默认从 9600 开始验证开漏边沿，未声明高速串口性能。

模块电源为 V5_MAIN → TPS2553DBVR → TLV75533 → AUX_3V3。Pi 3.3 V 只驱动限流开关 EN，并给 Pi 域逻辑供电，不作为模块的电源来源。169 kΩ、1% ILIM 电阻对应约 136–187 mA 的限流角落；正常模块预算 100 mA。输出 4.7 µF、10 kΩ 泄放；FAULT_N 接 Pi GPIO25 / 物理22，并上拉到 Pi 域。TPS2553 型号依据 TI SLVS841F 第 5、6、15、25 页和准确 DBV 封装；供应商搜索未完成，无库存或贴装服务承诺。

GPIO 仍为直接连接的 Pi 3.3 V 信号，模块只允许冷插拔且不得自带外部电源；ESD、辅助电源短路后 GPIO 经模块保护二极管反向供电的隔离尚未完成。限流开关不能替代信号隔离。常态 LDO 损耗约 0.18 W，故障限流上角可能约 0.36 W，需检查实际铜面积和温升。

加入 100 mA 模块预算后，5.1 V 总设计目标为 3.3 A。在输出上限 5.202 V、SYS≥3.5 V、效率≥85%、AON≤30 mA 的条件下，电池侧估算约 5.80 A，已接近 BQ25622 的 6 A 通路限制；这不是连续满载或低电量供电证明。

## 仍阻断交付的项目

编译与初步布局已通过；仍有大电流干线过细、主开关多形状焊盘网络丢失及地铜连通问题。TPS61088 的 VCC/SS、LCD 限流/供电和盖联锁网络已在完整检查中布通。还需信号保护、具体功率阻容身份、固件及瞬态/热验证。板形、固定孔和元件禁布区未与外壳冻结；水平 FH12 与斜屏原生 FPC 的到达性仍未闭合。禁止把此文或电路源用作已通过 DRC 的制造交付。
