c3ll256/rp-compute/design/pi_baseboard_lite/source/footprints/SOURCES.md

# Connector footprint and model provenance

HLE copper: official KiCad Connector_Samtec_HLE_SMD footprint installed with KiCad; https://gitlab.com/kicad/libraries/kicad-footprints/-/blob/master/Connector_Samtec_HLE_SMD.pretty/Samtec_HLE-104-02-xxx-DV_2x04_P2.54mm_Horizontal.kicad_mod . Licence GPL3 with KiCad library exception. The unavailable model reference alone is removed; all pads, mask, paste and courtyard geometry are unchanged. Original SHA256 bf43f4c413bd6e8136582d7cc66ba52116a9004bd580a3ca0c9c15d1ca7ca000; local SHA256 277f7073a3ca72cd462730ac083e16a8b461dc8d9efea81f041f8802fbaabda0.

ESQ copper remains exact supplier C3319198. Its downloaded STEP has excessive tails (4.915mm above the reverse PCB face); nominal selected tail is2.29mm.

Both new STEP files are deliberately modeled **nominal drawing references**, not supplier/manufacturer STEP assets. Build123d source and tool exports are stored as connector_fit_references and hle_fit_reference designs. Housing sizes, lead span and pitch come from https://suddendocs.samtec.com/catalog_english/esq_th.pdf and https://suddendocs.samtec.com/prints/hle-1xx-02-xxx-dv-xx-xx-x-xx-mkt.pdf . Cavities indicate pin locations only; internal contacts, latch force and solder shape are omitted. Geometry validates enclosure envelopes; physical mating and retention remain prototype checks.

esq-120-12-g-d-drawing-reference.step SHA256 1c4e4fd307d7f8a48d0965b581b95c1e37590160069f9e4f6665a3c083be10fc
hle-104-02-g-dv-drawing-reference.step SHA256 33dce5b72ab2367bfa9f56eeb865dfe7837cbf12eb2d9434a77a5909335b00b0

FH12A copper is the exact C5139870 supplier footprint, not a bottom-contact variant. Supplier description incorrectly says bottom contact; Hirose catalog printed p16 / PDF p11 and exact Hirose product identify FH12A-10S-0.5SH(55) as top contact. https://www.hirose.com/en/product/p/CL0586-0550-9-55 ; https://docs.rs-online.com/f450/0900766b813ce339.pdf . Supplier footprint has no STEP. step.parts exact searches returned no models. New fh12a-10s-0.5sh-drawing-reference.step is a deliberately modeled solid outer envelope from manufacturer dimensions (9.5mm maximum width,6.2mm depth,2.0mm closed height). Its supplier-footprint alignment uses the front silk datum atY=-4.825 and is an inference. Interior contacts, insertion-plane height, latch kinematics and manufacturing tolerances are not certified. Auxiliary CAD source fpc_fit_reference, build fe0aa85a8c4e251e13a801916aa5a466cb358a8239a1ee56114da2e84f1d2222, export export-19fcf5a99fdda02ba56fc46e77eb4c28. STEP SHA256 c1987e5cab3ebd5650d23145a0b3bee0ed8d268f3965fc8881b0c9ec5ba74388.

## Active J_LCD: SHOU HAN C5373447

Exact supplier footprint `jlcpcb:C5373447`, model UUIDc715515b56e04ed184074c34b1747904. API https://easyeda.com/api/products/C5373447/components ; STEP https://modules.easyeda.com/qAxj6KHrDKw4blvCG8QJPs7Y/c715515b56e04ed184074c34b1747904 . Downloaded STEP SHA256504b9584227db6e9942faceadb3f6e21c08d76d2b1e142ccfa9dea79109cca87, preserved as source/models/C5373447-easyeda.step. Source attribution: 嘉立创EDA / EasyEDA 官方库, https://lceda.cn/ , https://easyeda.com/ . Original library attribution retained in reference JSON. This detailed library model is not manufacturer-certified mating geometry.

Native supplier head-relative model Y=-1.2800076mm. Compiled footprint loader recenters copper +0.35mm along sourceY, proven by signal row+.95mm vs compiled+1.30mm and mechanical row-.95mm vs compiled-.60mm. Net model Yoffset=-.9300076mm, Zoffset=+1mm normalizes rawZ=-1mm to seating. Component origin source(0,24.65) places the model at sourceY23.7199924. Pin1 left, opening-Y, top contacts. Datasheet references and native-tail dimensional limitations: fpc-connector-comparison.md. Old FH12A envelope stays as historical asset and is not used by active J_LCD.

## Active generic through-hole sockets

J_PI uses KiCad_PinSocket_2x20_P2.54mm_GenericH8; J_MOD uses KiCad_PinSocket_2x04_P2.54mm_GenericH5. These are project copies of the installed upstream KiCad Connector_PinSocket_2.54mm library. The unrelated stock3D model stanza is removed. Every2D feature is uniformly rebased by native(+1.27,-24.13)mm for2x20 or(+1.27,-3.81)mm for2x04 so the body centroid matches the pipeline component origin. Relative geometry, pad numbers/shapes,1mm drills,1.7mm lands,2.54mm pitch/row spacing, silk and courtyard are unchanged; this is a rigid coordinate conversion, not a new land pattern. Exact upstream URLs and hashes are in source/models/generic-socket-provenance.json. KiCad library licence:GPL-3.0 with library exception.

The replacements are generic user-selected dimension-based sockets, not the old Samtec identities. Their STEP inputs are explicitly modeled nominal references owned by Workbench design connector_fit_references, revision94bdb20ebfb021eee5fb28a0ab9a212f363bf1e0b96fe9e3367b7aae941e9747. The extraction script reads its handed-off STEP and removes the display offsets; it does not reconstruct geometry.40Pin body51x5x8mm/tails3.5mm is user supplied;8Pin body10.16x5.08x5mm/tails3mm and0.64mm square tails are disclosed defaults. Socket cavities are illustrative, not a mating-depth guarantee. The body reference local frame agrees with native KiCad pin1(0,0), even row atX-2.54, successive pairs at modelY-2.54n; no bottom-side geometry is pre-mirrored.
