c3ll256/rp-compute/manufacturing/pi_baseboard_lite/releases/dfb9406b2d96fdd68e51510993e6d9fe0f0034fea6f9908f29e3cc6f32c65043/package/drill/pi_baseboard_lite-drill-report.txt

Drill report for board.kicad_pcb
Created on 2026-11-04T09:05:42

Copper Layer Stackup:
    =============================================================
    L1 :  F.Cu                      front
    L2 :  In1.Cu                    in1
    L3 :  In2.Cu                    in2
    L4 :  B.Cu                      back

Drill file 'board-PTH.drl' contains
    plated through holes:
    =============================================================
    T1  0.300mm  0.0118"  (39 holes))
    T2  1.100mm  0.0433"  (40 holes))

    Total plated holes count 79

Drill file 'board-NPTH.drl' contains
    unplated through holes:
    =============================================================
    T1  2.200mm  0.0866"  (2 holes))

    Total unplated holes count 2
