c3ll256/rp-compute/product/fastener-list.md

# 螺丝清单（装机最低数量）

设计优先匹配现有M3×6、M3×10、M3×12沉头螺丝。当前改版以M3×6统一10处：前盖4、底盖4、屏舱后侧2；其余打印件连接中，屏幕后压框4、屏舱前侧2仍用M2。新增树莓派托架到上壳的3处M2连接后，10/19处打印件连接为M3，另6处板件/金属固定沿用原孔与螺纹规格。M3×10和M3×12留作备用，不能直接替代短螺丝。默认参考90°沉头、头径6mm。打印沉头孔口径+0.4mm、深度+0.2mm，接收孔保持套件的PLA自成形补偿。

| 需要另购 | 最少数量 | 安装位置 |
|---|---:|---|
| ISO7046 M2×4 十字沉头 | 6 | 屏舱前侧2、屏幕后压框4 |
| ISO4762 M2×3 圆柱头内六角 | 2 | 基板，保留原孔，取消垫片 |
| ISO7046 M2.5×6 十字沉头 | 4 | 独立托架、树莓派及散热片原金属螺纹 |
| ISO7046 M2×6 十字沉头 | 3 | 独立托架到上壳 |

建议每种多备2颗。沉头螺丝长度含头；圆柱头螺丝按头下长度计。保留标准公制粗牙：M2螺距0.4、M2.5螺距0.45、M3螺距0.5mm。无需另加螺母或热熔铜螺母。数量以最终完成的CAD装配为准；打印配合、扭矩和重复拆装寿命仍需试装。
