c3ll256/rp-compute/design/pi_baseboard_lite/fpc-candidate-models.png

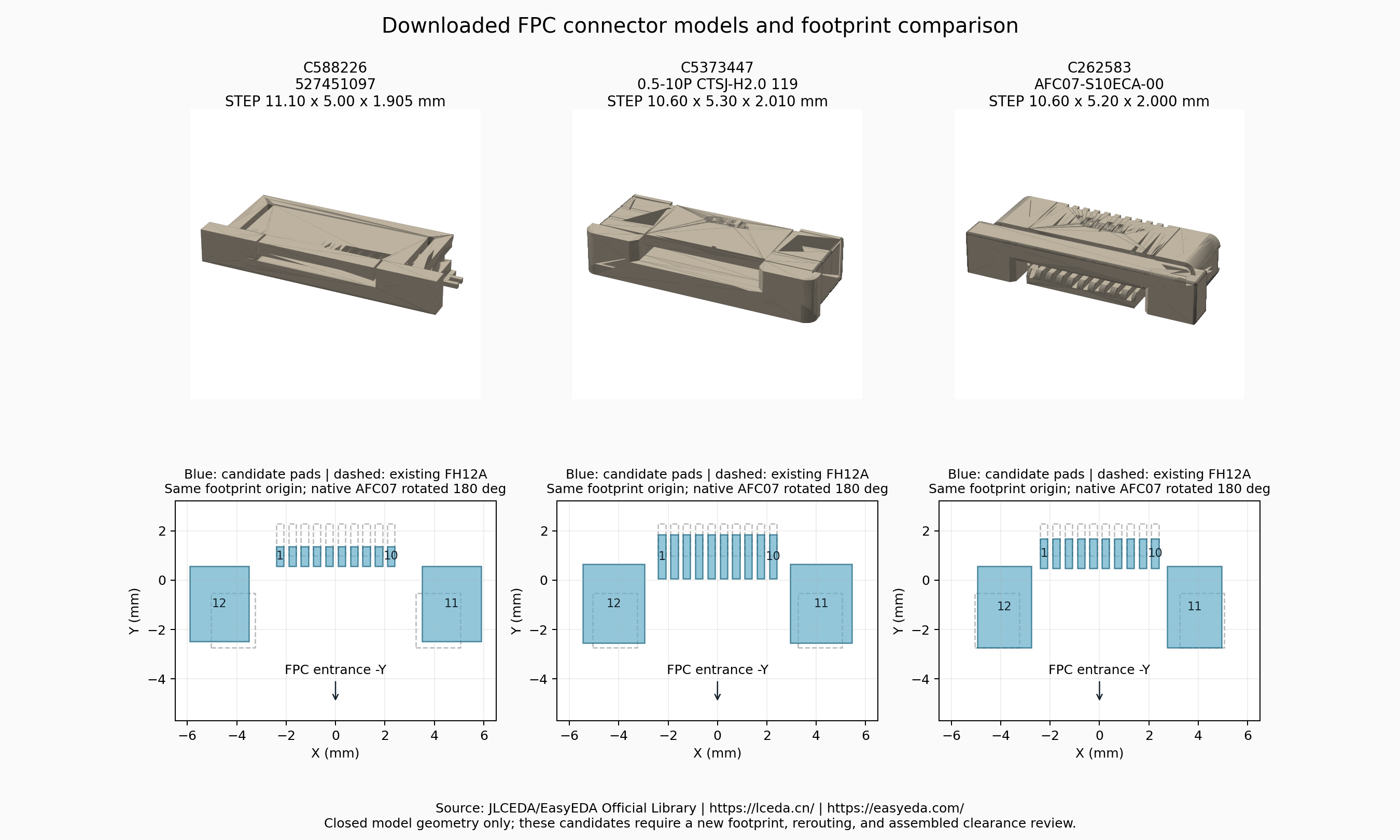
design/pi_baseboard_lite/fpc-candidate-models.png
