c3ll256/rp-compute/product/battery-supplier-inquiry.md

> 当前说明：用户已接手兼容电池采购，本文仅供参考，未发送。基板接口以battery-interface.md为准；不再等待此询证回复才能进入电路设计。

# LiPol 3300mAh 工厂保护包询证稿

状态：未发送、未取得报价、未下单；不是采购批准。

## 询证对象与已有线索
厂商：LiPol Battery Co., Ltd.
- LP446598：厂家3000mAh+目录明确列出3.7V、3300mAh、保护电路与引线、4.4×65×99mm。当前不知道整包持续放电电流。
- LPHD7859098：厂家高倍率目录列出3.7V、3300mAh、25C、7.8×59×98mm。仅为电芯线索，尚不知道有无工厂保护包版本；不能直接采用为成品电池。

## 可发送给厂家的正文
您好，我们为GPIO供电的Raspberry Pi 4B终端原型选购工厂装配的单节保护电池包。请提供LP446598完整保护版本的资料，并确认是否适用下列条件；若不适用，请说明能否基于LPHD7859098提供具有独立型号和图纸的完整工厂保护版本。

- 标称3.7V、3300mAh，容量与标称电压不改为相近值。
- 持续负载预算约5.63A，工程选型目标为整包至少8A持续能力（包括电芯、PCM、引线和接头），需要明确温度条件及降额；不能只给电芯倍率。请同时提供脉冲额定、保护阈值/延时及恢复条件。
- 请提供过充、过放、过流、短路保护范围；充放电温度范围；允许充电电压/电流。我们的0.5A、4.2V配置仅为暂定方案，最终以电池资料为准。
- 请提供连接器准确型号、极性图、引线线规/长度及绝缘规格。可建议工厂适配的连接器；目前XT30U仅为候选，不要求用户自行改焊带电包。
- 请提供包括PCM、绝缘、出线和突出物的最大尺寸/公差、厚度膨胀预留、重量及固定建议。目录尺寸不作为最终最大外形。
- 请提供接近6A放电的电压/容量曲线、内阻及温度/老化条件，供正常关机阈值与续航评估使用；不能以PCM切断作为日常关机方式。
- 请说明样品数量、交期、MOQ及匹配具体工厂包版本的运输/安全资料。价格和库存与安全适用性分别回复。

若需定制，请给出可追溯完整包型号与规格，不要将裸电芯规格当作完成保护后的额定。我们尚未授权制造、定制或采购。

## 收到回复后的准入条件
核实整包而非裸电芯；核对负载及保护动作裕量、充电与温度条件、线束/连接器、最大外形，然后更新BOM和关机策略。单凭目录容量或高倍率字样不得将bom_ready置为true。
