c3ll256/rp-compute/product/bom.csv

id | manufacturer | mpn | name | quantity | designators | supplier | lcsc_code | product_url | datasheet_url | image_url | selection_status | alternative_for | selection_reason | include_in_procurement_totals | assembly_population | assembly_method | assembly_side
compute | Raspberry Pi | Raspberry Pi 4 Model B 4GB | Raspberry Pi 4 Model B — 4GB default | 1 |  | Customer supplied — BYOP |  | https://www.raspberrypi.com/products/raspberry-pi-4-model-b/ | https://pip-assets.raspberrypi.com/categories/545-raspberry-pi-4-model-b/documents/RP-008344-DS-5-raspberry-pi-4-product-brief.pdf |  | selected_board_and_default_ram |  | User-supplied Pi4B,4GB remains default reference. Quantity1 is the assembled reference, not a board to buy with product kit. Baseboard mates viaGPIO; board revision/other models not yet qualified. User requests simple mount and enclosure access to native ports; no addedbaseboardUSB-A. User installation should not require soldering or individual GPIO jumpers. UsernowselectsPiUSB-Ccovered/interlockedwhiledocked;baseboardinputonly. Othernativeportsremainaccessible. Pi4B reference now placed with USB/RJ45 rear and micro-HDMI/AV right. Openings derive from imported board geometry; retention, actual plugs, GPIO stack and production fit remain unverified. No front ports. | False | not_mounted | not_assembled
display | SHARP | LS027B7DH01 | LS027B7DH01 | 1 |  | LCSC | C17492463 | https://item.szlcsc.com/18621659.html | https://media.digikey.com/pdf/Data%20Sheets/Sharp%20PDFs/LS027B7DH01.pdf |  |  |  | Primary LS027B7DH01 retained; user accepts LS027B7DH01A as a one-for-one alternative, not an additional panel. Total fitted quantity is1. One-piece housing has a rear-loading63.4x43.42mm negative pocket,0.3mm nominal clearance per side and1.77mm active-area offset. Optical opening59.4x35.88mm. Glass/FPC pose and13deg slope retained; front rise approximately1.67mm. Manufacturer drawing defines nominal glass; no exact panel STEP. Physical pressure and fit need testing. |  | not_mounted | not_assembled
display_fpc | SHOU HAN(首韩) | 0.5-10P CTSJ-H2.0 119 | 0.5-10P CTSJ-H2.0 119 | 1 | J_LCD | LCSC / 嘉立创 | C5373447 | https://item.szlcsc.com/6227364.html | https://atta.szlcsc.com//upload/public/pdf/source/20230321/8BA0DE4D38BE66CF3C031935900E1E28.pdf | https://alimg.szlcsc.com/upload/public/product/source/20230314/2CC6B96CFDF7B9A004D6A4B5EFB475EE.jpg | jlc_smt_local_review_passed_order_preview_pending |  | User delegated replacement. Exact top-contact 10P/0.5mm/0.3mm candidate with real bound STEP; recommended conductor>=3mm and stiffener>=4mm closest to native Sharp tail3.5/4mm. Focused JLC search returned no matching Basic candidate; Extended selected. New footprint and slide latch accepted through delegated selection. User requested JLC assembly on 2026-11-06; retain exact MPN and existing land pattern. |  | mounted | jlc_smt | top
ldo_3v3 | Texas Instruments | TLV75533PDBVR | TLV75533PDBVR | 2 | U_LCD_LDO,U_AUX_LDO | LCSC | C404027 | https://item.szlcsc.com/391018.html | https://www.ti.com/cn/lit/ds/symlink/tlv755p.pdf | https://alimg.szlcsc.com/upload/public/product/source/20230109/50C843B5EA4C4488BBA5D79AF7F2F72A.jpg | jlc_smt_local_review_passed_order_preview_pending |  | User requested JLC assembly on 2026-11-06; retain exact MPN and existing land pattern. |  | mounted | jlc_smt | top
display_buffer | Texas Instruments | SN74AHC125PWR | SN74AHC125PWR | 2 | U_BUF1,U_BUF2 | LCSC | C54529 | https://item.szlcsc.com/55547.html | https://www.ti.com/cn/lit/ds/symlink/sn74ahc125.pdf | https://alimg.szlcsc.com/upload/public/product/source/20221230/3C47C84BAAF1B86135DBFE6FB98B5466.jpg | jlc_smt_local_review_passed_order_preview_pending |  | AHC125 at local 3.3V, VOL<=0.1V at50uA versus DH01 VIL<=0.15V. Five buffered inputs; Pi GPIO12 controls COM, GPIO25 DISP. No large capacitive load on DISP. Verify waveform edges on prototype. User requested JLC assembly on 2026-11-06; retain exact MPN and existing land pattern. |  | mounted | jlc_smt | top
gpio_dock |  |  | 20×2Pin 短排母，2.54mm，塑高8mm，脚长3.5mm | 1 | J_PI | User supplied / generic connector selected by dimensions |  |  |  |  | selected_generic_through_hole_PCB_verified |  | User accepts selection from supplied specifications. Use the installed standard KiCad through-hole land pattern; drill1mm/pad1.7mm verified in the library. Row spacing2.54mm and0.64mm square tails are engineering defaults. No manufacturer SKU is invented. PCB uses a project copy of the published KiCad footprint with unrelated stock3D model stanza removed and a documented rigid translation of every2D feature to the body-centre origin; pad/row spacing, pad shape and numbering are unchanged. Nominal user-specification STEP comes from connector_fit_references; no copper is hand drawn. |  | mounted | through_hole | bottom
front_module_blank | Project custom | handheld_computer-front-module-blank | Custom replaceable front-module blank, 70x37mm | 1 |  | Prototype fabrication |  |  |  |  |  |  | Retain the existing flat cover and M3 mounting concept as the starting geometry. Socket air gap must be recalculated after the through-hole replacement and PCB stack are fixed; previous0.745mm result is not a replacement-part clearance. |  | not_mounted | not_assembled
front_module_screws | ISO 10642 standard | ISO10642-M3-0.5x6 | M3×6 90°沉头螺丝 | 4 |  | User-owned M3 stock |  |  |  |  |  |  | Uses user-owned M3x6 stock in the current cover joints. Printed seats add 0.4 mm diameter and 0.2 mm depth allowance. Verify actual head shape and printed thread fit. |  | not_mounted | not_assembled
gpio_aux_limiter | Texas Instruments | TPS2553DBVR | TPS2553DBVR | 2 | U_LCD_LIMIT,U_AUX_LIMIT | LCSC / JLCPCB | C55266 | https://jlcpcb.com/partdetail/TexasInstruments-TPS2553DBVR/C55266 | https://www.ti.com/lit/ds/symlink/tps2553.pdf | https://image.lceda.cn/szlcsc/C55266.jpg | jlc_smt_local_review_passed_order_preview_pending |  | TI SLVS841F pp5,6,15,25: active-high 2.5-6.5V adjustable current-limit switch, 169k 1% RILIM gives approximately 136-187mA limits ahead of a dedicated 3.3V LDO; normal module allocation is100mA. Pi3.3V only controls enable. Exact DBV stock KiCad footprint. Exact unchanged TPS2553DBVR (not the -1 latch-off variant) now matched to C55266 in the JLCPCB catalog and official EasyEDA library; preserve existing KiCad SOT-23-6 copper and topology. Extended retained to preserve the qualified exact part. User requested JLC assembly on 2026-11-06; retain exact MPN and existing land pattern. |  | mounted | jlc_smt | top
lite_header |  |  | 2×4Pin 双排直插母座，2.54mm，塑高5mm目标 | 1 | J_MOD | User supplied / generic connector selected by dimensions |  |  |  |  | selected_generic_through_hole_PCB_verified |  | User accepts selection from supplied specifications. Use the installed standard KiCad through-hole land pattern; drill1mm/pad1.7mm verified in the library. Row spacing2.54mm and0.64mm square tails are engineering defaults. No manufacturer SKU is invented. PCB uses a project copy of the published KiCad footprint with unrelated stock3D model stanza removed and a documented rigid translation of every2D feature to the body-centre origin; pad/row spacing, pad shape and numbering are unchanged. Nominal user-specification STEP comes from connector_fit_references; no copper is hand drawn. |  | mounted | through_hole | top
lite_c100n | YAGEO(国巨) | CC0603KRX7R9BB104 | CC0603KRX7R9BB104 | 3 | C_BUF1,C_BUF2,C_LCD_A | LCSC | C14663 | https://item.szlcsc.com/15331.html | https://atta.szlcsc.com//upload/public/pdf/source/20250214/096C4C206003071F5D32E5F0D8E7F8DF.pdf | https://alimg.szlcsc.com/upload/public/product/source/20250715/565F44E7FCAE51D13767AECBC328360D.jpg | jlc_smt_local_review_passed_order_preview_pending |  | Exact value, package and manufacturer part verified with supplier detail; JLC SMT assembly. No unqualified substitute. User requested JLC assembly on 2026-11-06; retain exact MPN and existing land pattern. |  | mounted | jlc_smt | top
lite_r10k | UNI-ROYAL(厚声) | 0603WAF1002T5E | 0603WAF1002T5E | 3 | R_LCD_BLEED,R_AUX_BLEED,R_FAULT_PU | LCSC | C25804 | https://item.szlcsc.com/26547.html | https://atta.szlcsc.com//upload/public/pdf/source/20200306/C422600_1E6D84923E4A46A82E41ADD87F860B5C.pdf | https://alimg.szlcsc.com/upload/public/product/source/20250618/A8DD5FF53E8BE3A05CC533FBBE26BF71.jpg | jlc_smt_local_review_passed_order_preview_pending |  | Exact value, package and manufacturer part verified with supplier detail; JLC SMT assembly. No unqualified substitute. User requested JLC assembly on 2026-11-06; retain exact MPN and existing land pattern. |  | mounted | jlc_smt | top
lite_r100k | UNI-ROYAL(厚声) | 0603WAF1003T5E | 0603WAF1003T5E | 7 | R_OFF_CLK,R_OFF_DATA,R_OFF_CS,R_OFF_DISP,R_OFF_COM,R_LCD_EN,R_AUX_EN | LCSC | C25803 | https://item.szlcsc.com/26546.html | https://atta.szlcsc.com//upload/public/pdf/source/20200306/C422600_1E6D84923E4A46A82E41ADD87F860B5C.pdf | https://alimg.szlcsc.com/upload/public/product/source/20221229/9CADD82CDD9E855DF3936BDC26AC09E2.jpg | jlc_smt_local_review_passed_order_preview_pending |  | Exact value, package and manufacturer part verified with supplier detail; JLC SMT assembly. No unqualified substitute. User requested JLC assembly on 2026-11-06; retain exact MPN and existing land pattern. |  | mounted | jlc_smt | top
lite_r169k | UNI-ROYAL(厚声) | 0603WAF1693T5E | 0603WAF1693T5E | 2 | R_LCD_ILIM,R_AUX_ILIM | LCSC | C22817 | https://item.szlcsc.com/23544.html | https://atta.szlcsc.com//upload/public/pdf/source/20200306/C422600_1E6D84923E4A46A82E41ADD87F860B5C.pdf | https://alimg.szlcsc.com/upload/public/product/source/20221228/E2B3E62C4EB13D0501DF0B3C0442EE14.jpg | jlc_smt_local_review_passed_order_preview_pending |  | Exact value/package verified; JLC SMT assembly. Extended resistor chosen only because no exact Basic match. User requested JLC assembly on 2026-11-06; retain exact MPN and existing land pattern. |  | mounted | jlc_smt | top
lite_c2u2 | SAMSUNG(三星) | CL21A225KBQNNNE | CL21A225KBQNNNE | 7 | C_LCD_D,C_LCD_IN,C_LCD_LIN,C_LCD_LOUT,C_AUX_IN,C_AUX_LIN,C_AUX_LOUT | LCSC | C377773 | https://item.szlcsc.com/350246.html | https://atta.szlcsc.com//upload/public/pdf/source/20160218/1457707763339.pdf | https://alimg.szlcsc.com/upload/public/product/source/20240318/586CF8A489086C6E8042B1D5672787EA.jpg | jlc_smt_local_review_passed_order_preview_pending |  | Exact value, package and manufacturer part verified with supplier detail; JLC SMT assembly. No unqualified substitute. User requested JLC assembly on 2026-11-06; retain exact MPN and existing land pattern. |  | mounted | jlc_smt | top
upper_shell_pcb_fixture | Project custom | handheld_computer-upper-shell-pcb-mount | Upper enclosure with integrated PCB beams and rear guide | 1 |  | Prototype fabrication |  |  |  |  |  |  | 76mm enclosure and76x59mm screen housing face with equal4.75mm borders outside66.5x49.5mm shallow border line. Glass/FPC datum unchanged; user accepts front rise approximately1.67mm. Front retainer screws at local(+/-27,-26.25), rear(+/-20,25.5); shell wells retained; independent bezel and thin flange removed. Rear pod foot stays flush atY57.5 with approximately26.29deg forward lean. Pi/heatsink offsetX-5mm, 44.5x83.5mm released PCB and capsule slots retained for passive ventilation. Existing85mm enclosure/PCB releases are not interchangeable. Side ports now clear default straight overmould envelopes12x6mm USB-C,11x6mm per micro-HDMI and diameter10mm audio, with enlarged full-depth bores and1.5mm HDMI separator; these are negative enclosure-clearance targets, not verified purchasable cable identities. Paired with M3 front-module and bottom-cover receivers, rear M3 pod mounts, and the current M2 retainer. Socket stack uses PCB bottomZ21.0 and Pi/sink lift1.3mm. Port openings follow Pi vertically; GPIO tail roof recess retains2mm skin and expanded rear-retainer gap clears untrimmed3.5mm leads. |  | not_mounted | not_assembled
pcb_upper_mount_screws | ISO 4762 standard | ISO4762-M2-0.4x3 | ISO4762 M2-0.4 x3mm socket-head cap screw | 2 |  | User-selected standard hardware |  |  |  |  |  |  | Two M2x3 socket-cap screws bear directly on unchanged0.8mm PCB through2.2mm NPTH; raised shell beams follow newZ21.0 datum. No spacers; nominal screw tipZ24.0 leaves3mm to deck. Physical torque and thread life untested. |  | not_mounted | not_assembled
compact_passive_heatsink | Geekworm | P165-B | Geekworm Raspberry Pi 4 11mm Embedded Heatsink (P165-B), standalone SKU100237 | 1 |  | Manufacturer / authorized distributor |  | https://geekworm.com/products/p165-b | https://geekworm.com/products/p165-b.js |  | selected |  | Retain user-selected Geekworm P165-B on Pi4B. Internal fan and its harness/mounts removed; fanless temperature performance requires prototype testing. |  | not_mounted | not_assembled
pi_upper_mount_screws | ISO standard | ISO7046-M2.5x6 | ISO7046 M2.5×6 十字沉头螺丝 | 4 |  | Manufacturer / authorized distributor |  |  |  |  | selected |  | Four ISO7046 M2.5x6 cross-recess countersunk screws pass through the current independent carrier and original Pi holes into P165-B metal M2.5 receivers. Carrier seat Z4.6 and Pi underside Z6.6 mm give 2 mm nominal metal engagement; verify physical thread depth. |  | not_mounted | not_assembled
lcd_retainer_screws | ISO standard | ISO7046-M2x4 | ISO7046 M2×4 十字沉头螺丝 | 4 |  | Standard hardware supplier |  |  |  |  | selected |  | Matches current thin retainer and PCB clearance. Six M2x4 screws in total: these four plus two front screen-pod fixings. |  | not_mounted | not_assembled
bottom_cover_screws | ISO 10642 standard | ISO10642-M3-0.5x6 | M3×6 90°沉头螺丝 | 4 |  | User-owned M3 stock |  |  |  |  |  |  | Uses user-owned M3x6 stock and current upper-shell bottom receivers. Printed seats add 0.4 mm diameter and 0.2 mm depth clearance. Bottom cover does not carry Pi loads. |  | not_mounted | not_assembled
screen_integral_frame | Project custom | handheld-screen-integral-frame | 一体屏舱前框（PLA打印） | 1 |  | Prototype fabrication |  |  |  |  |  |  |  |  | not_mounted | not_assembled
screen_flat_retainer | Project custom | handheld-screen-flat-retainer | 等厚屏幕后压框（PLA打印） | 1 |  | Prototype fabrication |  |  |  |  |  |  |  |  | not_mounted | not_assembled
screen_front_pad | Project custom | handheld-screen-front-pad-0p2 | 屏幕前侧无胶硅胶软垫，0.2mm | 1 |  | Prototype fabrication |  |  |  |  |  |  |  |  | not_mounted | not_assembled
screen_rear_pad | Project custom | handheld-screen-rear-pad-2p0 | 屏幕后侧无胶硅胶软垫，2mm | 1 |  | Prototype fabrication |  |  |  |  |  |  |  |  | not_mounted | not_assembled
screen_shell_front_screws | ISO standard | ISO7046-M2x4 | ISO7046 M2×4 十字沉头螺丝（前侧屏舱—上壳固定螺丝） | 2 |  | Standard hardware supplier |  |  |  |  |  |  | Two ISO7046 M2x4 cross-recess countersunk screws match the current low front pod joints and restricted PCB clearance. Seats add 0.4 mm diameter and 0.2 mm depth. Same exact screw as four rear-retainer fasteners; total product count six. |  | not_mounted | not_assembled
screen_shell_rear_screws | ISO 10642 standard | ISO10642-M3-0.5x6 | M3×6 90°沉头螺丝 | 2 |  | User-owned M3 stock |  |  |  |  |  |  | Uses user-owned M3x6 stock in current rear pod receivers. Printed countersinks add 0.4 mm diameter and 0.2 mm depth; physical head shape and fit require checks. |  | not_mounted | not_assembled
pi_independent_carrier | Custom printed part | pi_carrier | Pi 独立上壳托架 | 1 |  | Local FDM printing |  |  |  |  | selected |  | Independent carrier retains its3mm base plane,2mm rails and three2.4mm coplanar ears. Four Pi support pads and compensated screw seats rise1.3mm, Pi undersideZ6.6/seatZ4.6, retaining M2.5x6 screws and2mm nominal metal engagement. Pi GPIO cold-plugs before the three carrier screws are tightened; screws do not pull contacts into place. |  | not_mounted | not_assembled
pi_carrier_shell_screws | ISO standard | ISO7046-M2x6 | ISO7046 M2×6 十字沉头螺丝 | 3 |  | Standard hardware supplier |  |  |  |  | selected |  | Matches the three current independent carrier joints, allowing bottom removal with Pi/GPIO fixed. Recessed heads preserve nominal 0.8 mm bottom clearance; verify actual printed fit. |  | not_mounted | not_assembled
bottom_closure | Custom printed part | handheld-bottom-closure | 终端底盖（不承载树莓派） | 1 |  | Local FDM printing |  |  |  |  | selected |  | Matches the current upper shell and independent Pi carrier; closes the enclosure without carrying Pi or disconnecting GPIO during removal. Physical fit remains unverified. |  | not_mounted | not_assembled
