c3ll256/rp-compute/design/pi_baseboard_lite/source/models/generic_40pin-nominal.step

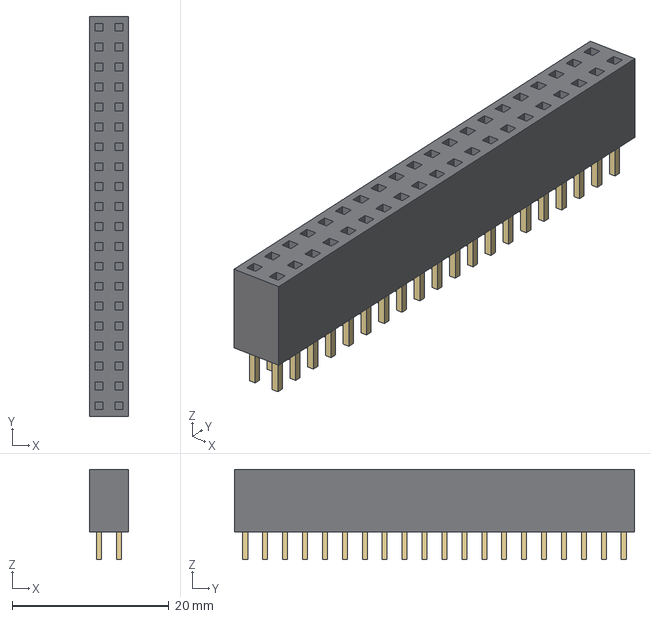
[picture p6: CAD file, 2026-11-07]
design/pi_baseboard_lite/source/models/generic_40pin-nominal.step
5.00 x 51.0 x 11.5 mm
