c3ll256/rp-compute/design/handheld_computer/source/assets/d29ec8dca230f3f99ec135acc27b27e6eae845fa7975f36bf66daf0f853f6c27.step

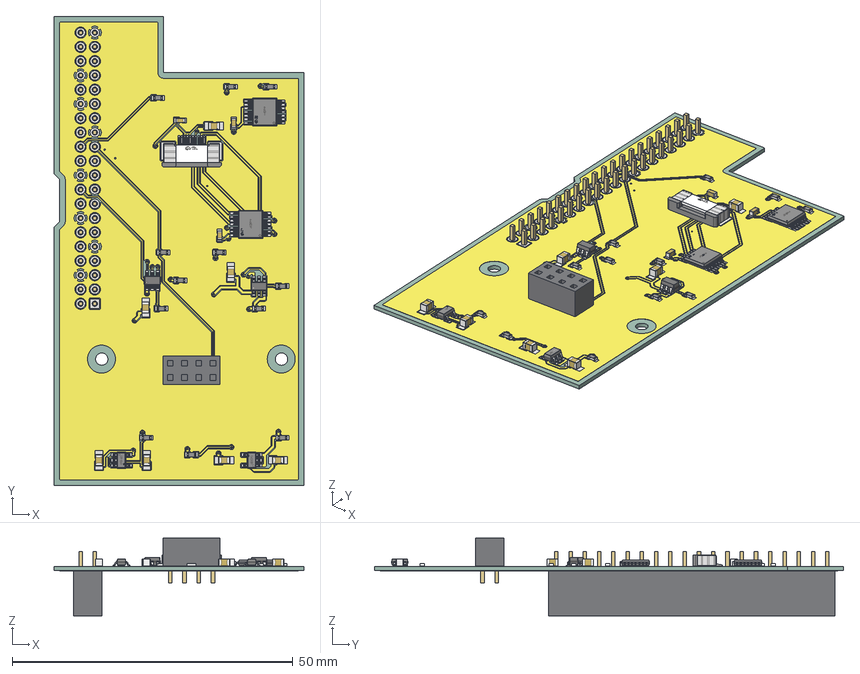
[picture p7: CAD file, 2026-11-07]
design/handheld_computer/source/assets/d29ec8dca230f3f99ec135acc27b27e6eae845fa7975f36bf66daf0f853f6c27.step
44.5 x 83.5 x 13.9 mm
C0805_L2.0-W1.3-H1.3 x 7
R0603 x 12
SOT-23-5_L2.9-W1.6-H1.1-LS2.8-P0.95 x 2
TSSOP-14_L5.0-W4.4-H1.0-LS6.4-P0.65 x 2
SOT-23-6 x 2
FPC-SMD_10P-P0.50_0.5-10P-CTSJ-H2.0-119
C0603_L1.6-W0.8-H0.8 x 3
board_copper
board_pad
board_via
board_PCB
