c3ll256/rp-compute/design/pi_baseboard_lite/source/models/generic_8pin-nominal.step

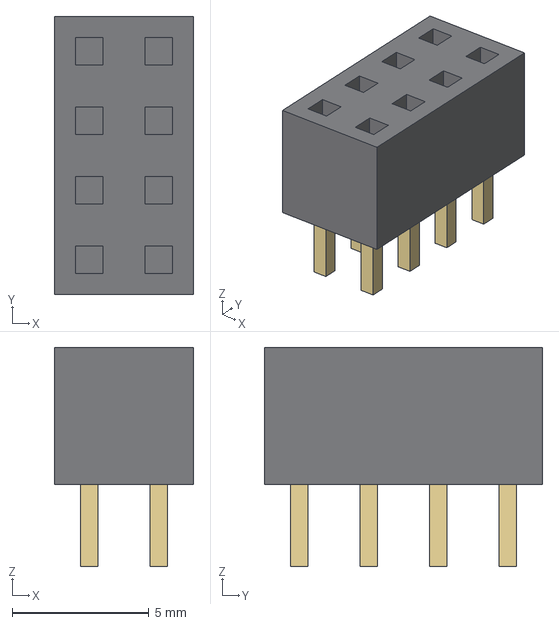
[picture p8: CAD file, 2026-11-07]
design/pi_baseboard_lite/source/models/generic_8pin-nominal.step
5.08 x 10.2 x 8.00 mm
