c3ll256/rp-compute/design/handheld_computer/source/assets/d5eedbdd2e46ee9693cc34f90c7cba7747c453ec3ba94badc9c13c7c85ab0b27.step

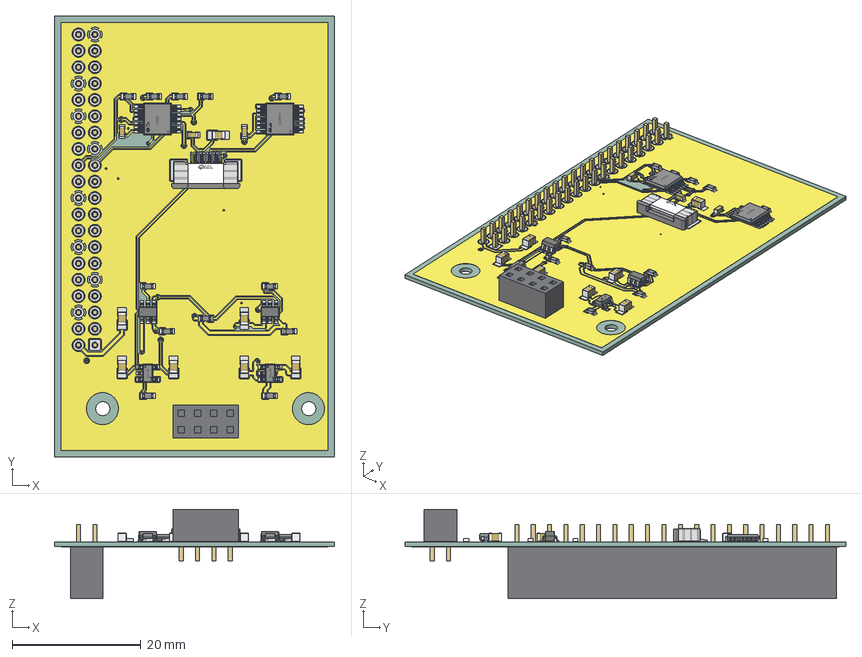
[picture p9: CAD file, 2026-11-07]
design/handheld_computer/source/assets/d5eedbdd2e46ee9693cc34f90c7cba7747c453ec3ba94badc9c13c7c85ab0b27.step
43.5 x 68.5 x 13.9 mm
C0805_L2.0-W1.3-H1.3 x 7
C0603_L1.6-W0.8-H0.8 x 3
R0603 x 12
TSSOP-14_L5.0-W4.4-H1.0-LS6.4-P0.65 x 2
SOT-23-5_L2.9-W1.6-H1.1-LS2.8-P0.95 x 2
FPC-SMD_10P-P0.50_0.5-10P-CTSJ-H2.0-119
SOT-23-6 x 2
board_copper
board_pad
board_via
board_PCB
