c3ll256/rp-compute/design/pi_baseboard_lite/source/models/hle-104-02-g-dv-drawing-reference.step

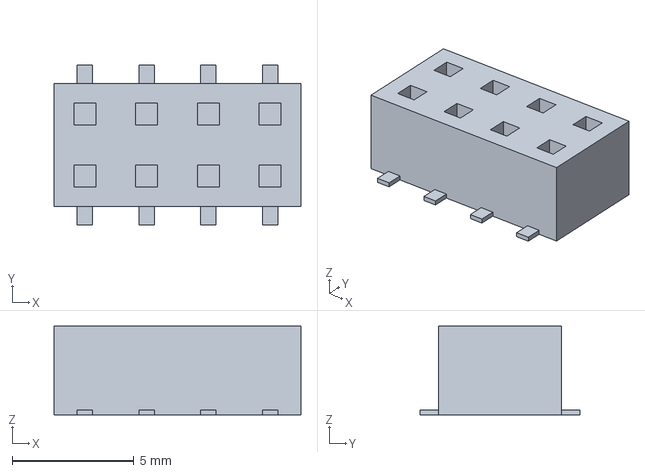
[picture p10: CAD file, 2026-09-30]
design/pi_baseboard_lite/source/models/hle-104-02-g-dv-drawing-reference.step
10.2 x 6.60 x 3.66 mm
