c3ll256/rp-compute/design/handheld_computer/source/assets/7be47336983ab285b75e6c7d2a93d2c29418654a82397f66cf8ef8e56ad6b53d.step

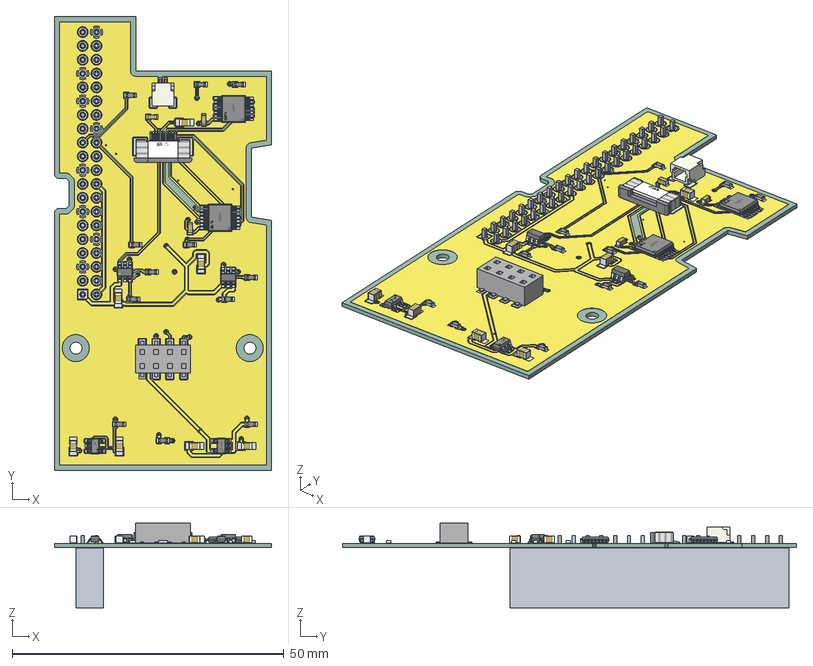
[picture p11: CAD file, 2026-10-04]
design/handheld_computer/source/assets/7be47336983ab285b75e6c7d2a93d2c29418654a82397f66cf8ef8e56ad6b53d.step
40.0 x 83.5 x 15.6 mm
C0805_L2.0-W1.3-H1.3 x 7
R0603 x 12
TSSOP-14_L5.0-W4.4-H1.0-LS6.4-P0.65 x 2
C0603_L1.6-W0.8-H0.8 x 3
hle_nominal_reference
SOT-23-5_L2.9-W1.6-H1.1-LS2.8-P0.95 x 2
SOT-23-6 x 2
FPC-SMD_10P-P0.50_0.5-10P-CTSJ-H2.0-119
JST_SH_SM02B-SRSS-TB_1x02-1MP_P1.00mm_Horizontal
board_copper
board_pad
board_via
board_PCB
