c3ll256/rp-compute/design/handheld_computer/source/assets/e2f8b7cbed1d020a8861be66a5f32019d9404dfb20410347d0f201a42a6ba793.step

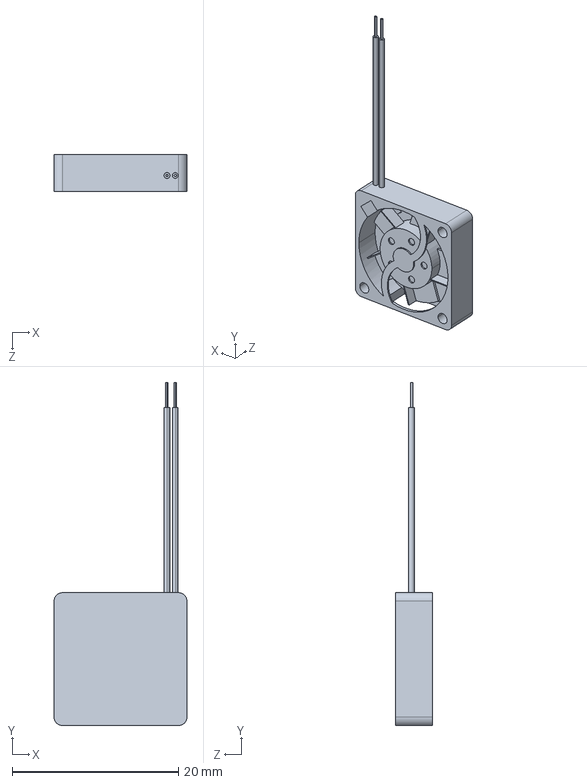
[picture p13: CAD file, 2026-10-04]
design/handheld_computer/source/assets/e2f8b7cbed1d020a8861be66a5f32019d9404dfb20410347d0f201a42a6ba793.step
16.0 x 41.3 x 4.50 mm
