c3ll256/rp-compute/design/handheld_computer/source/assets/d26b27a28b2c06ec16336d413a92da0bc5e95f6af88dec4677c65cf84bc93566.step

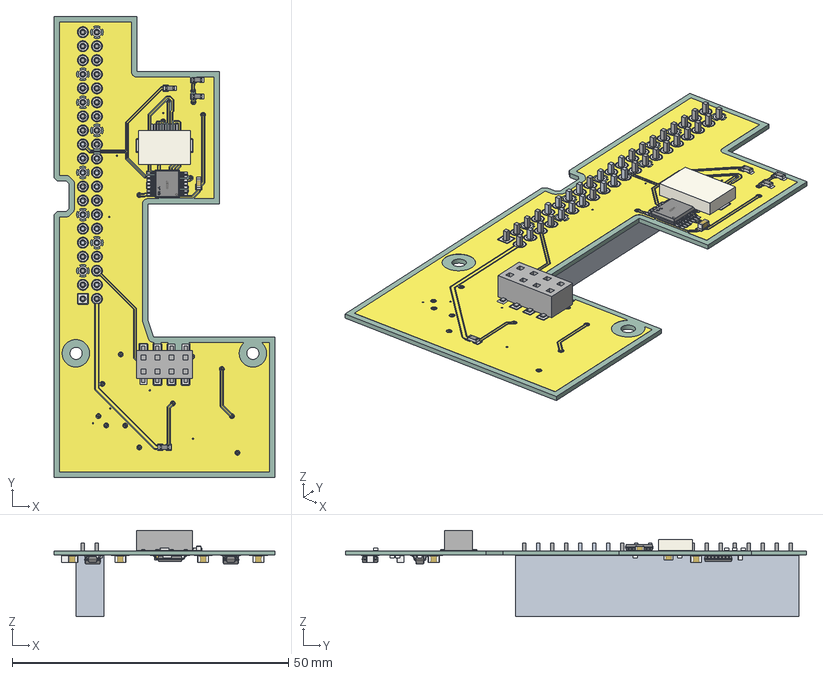
[picture p14: CAD file, 2026-10-04]
design/handheld_computer/source/assets/d26b27a28b2c06ec16336d413a92da0bc5e95f6af88dec4677c65cf84bc93566.step
40.0 x 83.5 x 15.6 mm
R0603 x 12
C0603_L1.6-W0.8-H0.8 x 3
hle_nominal_reference
TSSOP-14_L5.0-W4.4-H1.0-LS6.4-P0.65 x 2
FH12A_closed_envelope
SOT-23-6 x 2
C0805_L2.0-W1.3-H1.3 x 7
SOT-23-5_L2.9-W1.6-H1.1-LS2.8-P0.95 x 2
board_copper
board_pad
board_via
board_PCB
