c3ll256/rp-compute/design/handheld_computer/source/assets/1638bf7b0e7a0d38eff850ffa7924412043987a2e04c416c37742131c9fe4f0c.step

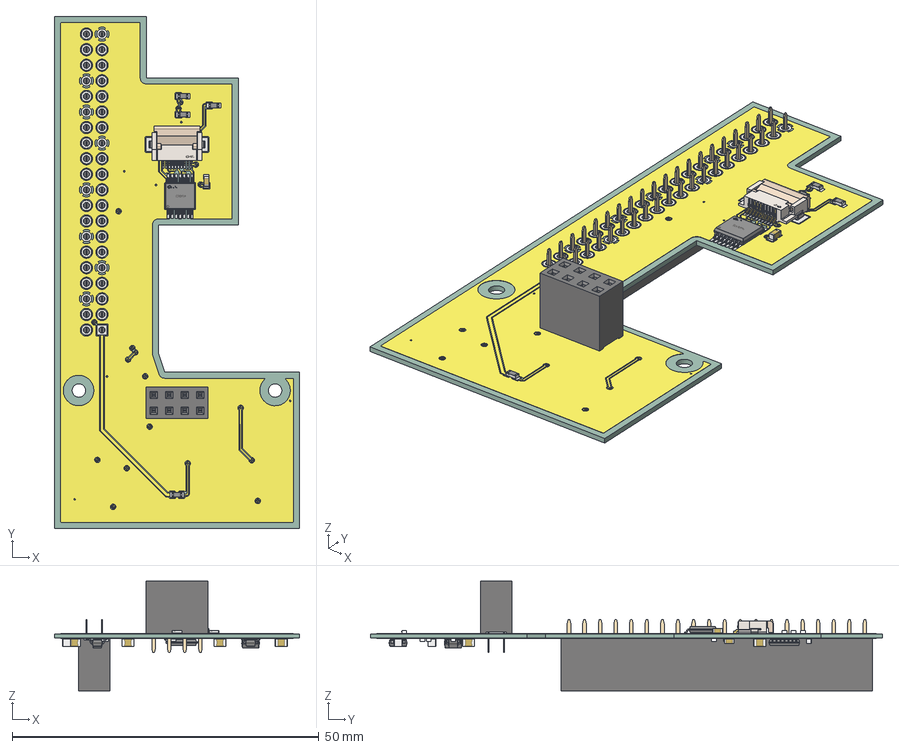
[picture p15: CAD file, 2026-09-30]
design/handheld_computer/source/assets/1638bf7b0e7a0d38eff850ffa7924412043987a2e04c416c37742131c9fe4f0c.step
40.0 x 83.5 x 17.9 mm
R0603 x 12
PinSocket_2x04_P2.54mm_Vertical
C0603_L1.6-W0.8-H0.8 x 3
FPC-SMD_FH12-10S-0.5SH-55
TSSOP-14_L5.0-W4.4-H1.0-LS6.4-P0.65 x 2
SOT-23-6 x 2
C0805_L2.0-W1.3-H1.3 x 7
SOT-23-5_L2.9-W1.6-H1.1-LS2.8-P0.95 x 2
PinSocket_2x20_P2.54mm_Vertical
board_copper
board_pad
board_via
board_PCB
