c3ll256/rp-compute/design/handheld_computer/source/assets/3b2aa6ea5a8299a7c540040ff2dcab3c1f86d838a6baf72e4eaa37314cc746d8.step

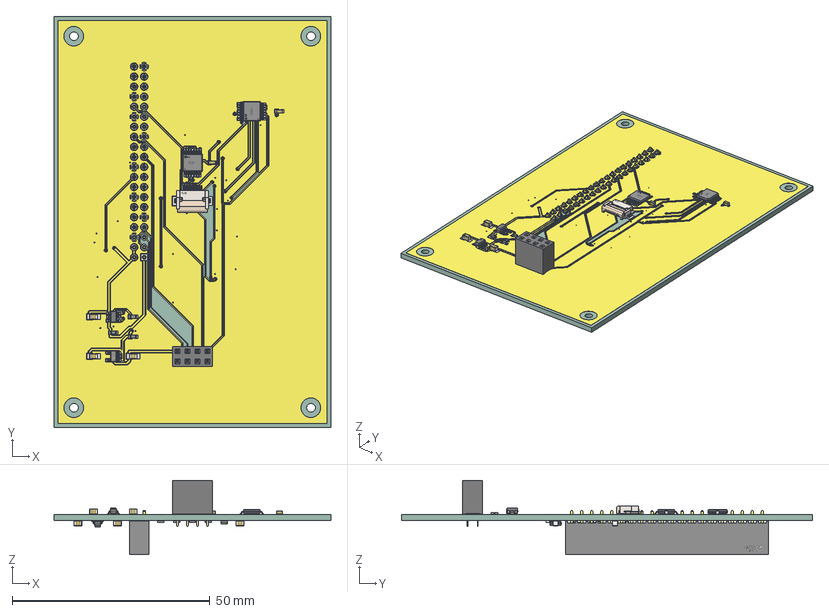
[picture p16: CAD file, 2026-09-26]
design/handheld_computer/source/assets/3b2aa6ea5a8299a7c540040ff2dcab3c1f86d838a6baf72e4eaa37314cc746d8.step
70.0 x 104.0 x 18.7 mm
C0805_L2.0-W1.3-H1.3 x 7
C0603_L1.6-W0.8-H0.8 x 3
TSSOP-14_L5.0-W4.4-H1.0-LS6.4-P0.65 x 2
FPC-SMD_FH12-10S-0.5SH-55
R0603 x 12
SOT-23-5_L2.9-W1.6-H1.1-LS2.8-P0.95 x 2
SOT-23-6 x 2
PinSocket_2x04_P2.54mm_Vertical
HDR-TH_40P-P2.54_SSQ-120-01-F-D
board_copper
board_pad
board_via
board_PCB
