c3ll256/rp-compute/design/handheld_computer/source/assets/e9d0b14513dfc84f1e9be9e3b1d0c5c710fa12b2abdcae6ad9b5880e4097a0e9.step

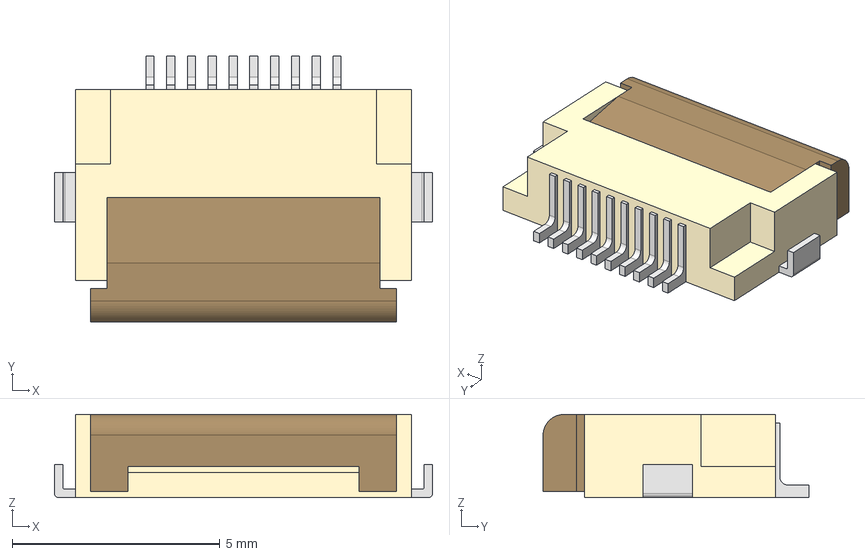
[picture p17: CAD file, 2026-09-23]
design/handheld_computer/source/assets/e9d0b14513dfc84f1e9be9e3b1d0c5c710fa12b2abdcae6ad9b5880e4097a0e9.step
9.10 x 6.40 x 2.00 mm
lock
pins
