c3ll256/rp-compute/(list of files, cad)

Other CAD files:
manufacturing/handheld_computer/releases/export-5c09e611b7e9bd2162d20e6ecce9507e/model.step
design/handheld_computer/source/assets/fc6d293414ed15fcebd1226aa4a9bee691ebe59ee7340ee3075cb63742b08fa8.step
design/handheld_computer/source/assets/35b0f99d114a5296c8534292aa213fbe2e80c83e729fce01319fcae56cbfd9e1.step
design/handheld_computer/source/assets/61d5b3a7143d8e90b7398d9ddd06727d30961002151399670a05275371fd1d5e.step
design/handheld_computer/source/assets/154f66f41101488afd6b8aa20b527c294befcae4e79a504b02ed9442074bb3b3.step
design/handheld_computer/source/assets/10697cc559f1ad6b5839bcfca5e1267dab13b5adc0608a2b78225cf2723387fa.step
design/handheld_computer/source/assets/1906d615405ba20aaaf5b4bdcd41f19fe49b8e82a87ab1387e0f1d1abfe6bbbe.step
design/handheld_computer/source/assets/72020e05b8b9ed9c8f8398b6ae4fe3d29c9e9aa3aae515751e6f7a0be198fadd.step
design/handheld_computer/source/assets/72635669da4be260878db47e3bb1eed03b253bbe890fcab37ef6e895f3cb8fa1.step
design/handheld_computer/source/assets/fc63232fc7ddf1972848edb829711607d9a1d65cc299b42f3427e71f542c520a.step
design/pi_baseboard_lite/source/models/C5373447-easyeda.step
manufacturing/handheld_computer/releases/export-fcf4f55a7e77369ebba3fce4ada18ec2/model.step
