c3ll256/rp-compute/design/handheld_computer/screen-installation.md

# 新版 PCB 与 FPC 装配空间

当前导入PCB发布8816a764、CAD版本ec22671b23ade2b894c2bd11afd797e6d93edd25c97aab1550952768fc5b8ca5。保持85×115mm外形、27mm面板、13°屏舱及1mm前沿。31个元件正面，背面仅J_PI。PCB仍固定于上壳，屏后框当前使用四枚ISO7046 M2×6沉头螺丝，打印接收端仍由printed-screw-joint-v1生成。

上壳和模块盖增加12处局部让空，普通正面元件最小间隙1.555001mm，U_BUF1为1.6mm；主壁2.4mm，局部最薄顶1.255001mm，需要样机强度验证。新版板对所查真实Pi、壳体、螺丝、屏框及名义玻璃无实体交叠。屏螺丝距板基材1.292813mm，固定螺丝检查通过。

接口为SHOU HAN C5373447（0.5-10P CTSJ-H2.0 119），10针0.5mm、上接触、入口-Y、抽拉锁扣；不能掀锁扣。铜面朝上，座端子=11−屏端子。详细STEP来自嘉立创EDA/EasyEDA库，内部配合并非厂家认证。按1.5mm抽拉量，保守打开包络与所查壳体及名义玻璃最小间隙2.7mm。屏舱/压框增加7.5×7×7.5mm尾部通道。建议拆下屏舱操作；合壳后的手指可达性未验证。

排线13.7±0.5mm仍是授权估计，非厂家公差。Sharp规定出口展开0.8–6mm内弯折、内R≥0.45mm、末端4mm保持平直，不超过三次往复。2026-11-07屏幕平面整体降低0.8mm后（屏幕中心Z35.31→34.51），按规格书插入2.7mm，13.2/13.7/14.2mm屏线最后一道弯分别在5.58/5.75/5.91mm结束，全部在6mm内；详见下文“完整排线空间”。插入深度来自规格书剖面图的解读，库模型内部是实心块，无法确认止挡；完整插接尚未实物确认。

断电并卸下屏舱，用软垫独立支撑玻璃，必要时先拆Pi。实测尾部总长、补强位置、槽面和止挡后，在厂家允许区形成一次背折；均匀拉出抽屉两端，扶住补强端铜面向上平直插入，再均匀闭锁并装屏舱。不能拉伸尾部、悬挂玻璃或追加反复折弯。当前J_FAN在PCB正面后部，历史底面线束路线不适用。

## 以下为保留的历史制作与装配记录

下述旧M2×5、翻转底接触座、固定尾部终点和“没有PCB”的说明均属于历史版本，以本页当前说明及fpc-route.json为准；制作注意事项和未做实物试验的记录保留。

保留原玻璃定位槽63.4×43.42mm、每侧名义0.3mm间隙、有效区偏置Y=-1.77mm、13°倾角和1mm前沿（含0.3mm分缝）。不做PCB。

## 固定结构

后托框通过四枚ISO4762 M2×5内六角螺钉固定于屏舱内侧前后承台。坐标均在屏幕有效区局部平面：X=±20mm，Y=-28/+25.5mm；螺钉从背面装入，2mm通孔层、3mm名义啮合由printed-screw-joint-v1生成。螺钉只夹紧塑料硬限位，不把玻璃作为螺钉承压垫片。原侧壁方案会相交，已由前后承台取代。

深色内框增加70×47×1.2mm背面止口，原定位槽不变。止口夹在屏舱屋面底面与后托框的台阶之间，防止内框连同屏幕脱出。前部螺钉承台对应止口有让位缺口。底座仅扩大隐藏内部通道到71×54mm，并增加承台让位孔，外部接口及前端造型不变。

玻璃前/后分别使用0.20mm遮光软垫和1.00mm背部软垫，均为自定义裁切形状、无胶贴覆偏光片。后垫只沿边缘支承，中央悬空。模型厚度是装配目标，不代表已验证的泡棉压缩曲线；实际材料、玻璃公差与屏幕均匀性必须在样件上确认。不得使用氯丁橡胶，不得把胶粘到偏光片。

## 完整排线空间

完整路径数据在fpc-route.json。屏线从玻璃边（屏幕局部Y=-23.18，尾部中面Z=-2.23，整机坐标Y=-0.563、Z=27.124）沿193°方向伸出，向背面折回约167°后水平插入主板上的J_LCD。Sharp要求：距玻璃边0.8–6.0mm内折弯，内R≥0.45mm，不能向前偏光片方向反折，总往复折弯不超过三次。

J_LCD为SHOU HAN 0.5-10P CTSJ-H2.0 119（立创C5373447），抽屉式上接触，插口朝前（-Y），焊脚在后。整机坐标：抽屉前沿Y=2.17，壳体插口前沿Y=3.07，插口高度Z=22.845–23.245（屏线中面取23.045）。库模型壳体内部是实心块，只画了约0.9mm深的插口，止挡位置无法从模型量出；按规格书剖面A-A取壳体前沿到止挡2.7mm（止挡约Y=5.77），这是对图纸的解读，不是认证尺寸。屏幕①号脚SCLK对应座焊盘10（+X端），⑩号脚VSSA对应焊盘1（-X端），座端子=11−屏幕端子，10个焊盘的坐标与网络已核对。

**2026-11-07复核：** 主板为配合8mm Pi插座从Z21.8下移到21.0后，屏线下降量一度变为4.98mm，最短合法路线也要到6.18mm才折完，不合格。随后把屏幕平面整体降低0.8mm（屏舱底座和接缝不动，屏舱前沿高出底座0.575mm），下降量回到4.08mm：13.2/13.7/14.2mm屏线最后一道弯分别在5.58/5.75/5.91mm结束，合格；14.2mm只剩0.09mm余量。若实际插入只有约1.9mm，13.7mm刚好到6.0mm、14.2mm会超出，所以插入深度是样机首要检查项。按三种长度扫掠的屏线带（近玻璃段按9.5mm宽）到面框0.58mm、玻璃0.80mm、外壳≥2.2mm、前软垫1.63mm。

配套改动：屏舱前部两颗固定螺丝从Y=4.2移到9.2，保证盲孔上方仍有面皮；主板左后角限位块改为7mm宽、Y=22–29，让开下降后的后托框（0.39mm）；背部软垫前边条在Pi排针最前两根尾端上方开5.8×1.6mm缺口（间隙0.67mm）。Pi排针尾端到后托框0.91mm、到外壳0.585mm，与改动前相同。

**13.7mm玻璃边到尾端总长是布局估计（±0.5mm为评审余量），原图未给出该总长及公差，不能当作厂家保证尺寸。** 不允许靠拉伸FPC补偿。

屏线靠近玻璃的前6–7mm宽8.64–9.5mm，之后收窄到5.5mm补强段。屏舱和后托框里保留11mm宽的折弯让位槽，面框和后托框另有7.5mm宽的局部让位。护栏不夹玻璃粘接处或铜线；连接器和玻璃各自固定，不能依靠排线承重。

## 装配顺序

1. 断开外部电源并隔离电池；拆下屏舱，在软垫上朝下放置。若底部操作受Pi阻挡，先拆Pi，不带电检修。
2. 清洁接触面并去除屏幕运输保护膜；放入前遮光垫，从背面装入玻璃，不撬边、不粘偏光片。
3. 放后垫、后托框；四枚M2螺钉交替轻拧至塑料硬限位。不得继续加力企图压平玻璃；出现图像不均或应力纹时停止。
4. 用合适圆弧治具形成一次背折，保持起弯直段。两端均匀拉开J_LCD抽屉，扶住补强尾端，铜面朝上插到止挡，推回抽屉，再安装屏舱。按当前高度，折弯会超出Sharp的6.0mm推荐区（见上），实物上需确认插到底后不在玻璃出口处受力。
5. 检查玻璃不松脱、无应力纹、排线不碰锐边、锁扣可拆，之后才进入有完整电路的上电验证。

## 制作边界

后托框及螺纹承台默认PLA建模；没有材料热性能、跌落、打印收缩或拧紧扭矩验证。M2自成形孔的库补偿需要先做试孔。止口和前沿局部薄壁不可被“有效实体”检查代替强度测试。软垫是裁切件，不是FDM件。打印时螺钉孔轴朝上；屏舱斜面与前后承台可能需要支撑，拆支撑不得伤及止口及FPC让位面。

本轮只解决屏幕子装配的CAD结构和路径目标。Pi固定、散热、电池仓、屏舱/底盖总装固定和工作联锁仍属于已有整机待办。没有电气/PCB设计、整机打印适配或实物压力测试。

## 当前紧凑板与上接触接口更新

当前采用C5373447（SHOU HAN 0.5-10P CTSJ-H2.0 119）抽屉式上接触座，入口朝前（-Y），折回露铜朝上。主板0.8mm厚，板底Z=21.0，连接器整机坐标见上文“完整排线空间”。早期方案用的是倒装的Hirose FH12底接触座，悬在屏舱下方；该方案已经废弃，只留下屏舱里那条11mm让位槽。保留13.7±0.5mm估计；离壳安装屏舱，轻弯一次、保持补强区平直，接插与抽屉操作仍需样板验证。
