c3ll256/rp-compute/design/handheld_computer/cooling-assembly.md

# Pi4被动散热片与独立内置风扇装配

当前CAD 2c7c2ccf1ef5fbca92db9749a5a5c9e1582444ba7004401cecb487c23b987f20，HAT发布 dbacb2cc60cdef69951f80af131442ea24b1ed03394f9e446a1f890bf9a1d209，STEP SHA256 fc63232fc7ddf1972848edb829711607d9a1d65cc299b42f3427e71f542c520a。外壳仍85×115mm；高GPIO、低8针、FPC上接触向下入口保留。

## 选型与固定

被动散热片按Geekworm P165-B单件SKU100237规格65×55×11mm安排；不含附加3010风扇，不使用套装下方加高铜柱。四枚ISO7046 M2.5×6沉头螺丝从上壳的下托耳穿过Pi原有Ø2.7孔，进入散热片四角金属螺纹2.4mm。沉头只在打印托耳，PCB孔不做沉头；无独立散热片支架。螺丝头到底盖1.1mm。先四角带入、交替轻拧，确认PCB平直、CPU/RAM贴合，不能靠拧紧强压芯片。

P165-B只有外尺寸、用途和四角螺纹有厂家依据。CAD底部落差、CPU/RAM接触块和GPIO/DSI/CSI/AV/PoE避让是照片推定，模型调整不是要求加工买来的金属件。高ESQ母座端部参考间隙仅0.345mm；实物必须确认插到底、不顶金属。TIM暂画0.25mm间隙，套装厚度未知；根据实际落差选择必要的薄贴片并检查接触，不把0.25mm当采购规格。

独立风扇Nidec F16FB-05LLC16×16×4.5mm，靠近左侧壁的一体托架固定，进气面向上、出口朝左-X；风扇中心(-29,-38)mm，安装旋转(180,0,270)度。旋转后的19×29×1.4mm薄压框和两枚ISO7046 M2×4沉头螺丝固定；不用风扇自身Ø1.5孔。三处2×2×0.5mm软垫适配名义4.5mm厚；实测风扇若偏离，应调整软垫/硬限位并重新核对夹紧与自由转动。无跨越主板的高风罩。外露模块盖四枚M2×4、屏幕后压框四枚M2×6均为沉头；HAT内部两枚M2×4普通头保留。

## 供电和线束

HAT GPIO-header物理2/4的5V经V5_PI_IN走线到J_FAN1，物理6GND到J_FAN2。额定40mA，按100mA留预算；与原有两支200mA支路共享500mA预算。不上3.3V信号脚，不占用LCD COM的GPIO12；默认随Pi电源常转，无调速电路。

HAT底面J_FAN为JST SM02B-SRSS-TB侧入两针座，源位置(0,-25)，世界入口朝前-Y。插头SHR-02V-S、触点SSH-003T-P0.2-H，由工厂用合规32AWG短引线转接原风扇36AWG，绝缘并做极性/拉力测试。原36AWG不能直接按SH触点压接规格处理。用户只插两针线，不焊HAT、不逐根拉GPIO。接头原厂外购、工厂手工安装；未声称JLC自动贴片可用。

线束从风扇右后角向右离开壳体，再抬到HAT下方、沿前沿回插座。含端头52.521mm线束路径已绕开HAT固定螺丝和背面器件；空间保留按两线束直径1.4mm、最小弯曲半径2mm、原厂线长下限70mm核对。此路径是空间保留，厂家STEP上的直导线不是实际折线。保留可拆底盖装配入口，插好后做应力释放，不能拉扯风扇焊点或让线穿过进气口。

## 风道和检查

后部左侧四条2.4×6mm进气孔，总57.6mm²；左侧风扇旁四条2.4×4.5mm排气孔，总43.2mm²。前侧旧排气孔封闭。空气在壳内经过散热片区域，再由风扇朝左侧抽出；出口紧邻侧壁，名义间隙3.1mm，无密封长风道，可能有旁路。使用时不能堵住左侧进排气孔。风扇按最大5mm厚时，上方Ø12mm×3mm进气空间无遮挡。散热片到上壳最近1.6mm，普通HAT正面元件至少1.505918mm。逐实体几何、接头和弯线探针无干涉；布线DRC0错误/0未连接，另有34条生成库封装提示。

这些是名义空间检查，不能证明风量或温升。风扇堵转静压只有5.5Pa，样机需合壳满载测试CPU温度/降频、RAM和HAT温度、噪声及风扇启动。先断电冷装：安装风扇、检查转动，装散热片/Pi四角、插高GPIOHAT并紧固其上壳梁，接风扇插头，再在拆下的屏舱内连接FPC并装回。屏幕原生排线长度仍为用户授权估计13.7±0.5mm，需要实物确认。
