c3ll256/rp-compute/design/pi_baseboard_lite/electrical-export-issue.md

# 电气校验修复与复检记录

检查构建：ecf9d3b0bce379ab317601a3061dbe14d03f04cdef9805de9e6a52e56c17b1dd。
生产发布：dfb9406b2d96fdd68e51510993e6d9fe0f0034fea6f9908f29e3cc6f32c65043。

## 已修复

此前记录的64项未连接错误在本轮重新生成的完整原理图中已经消失；当前导出保留了24个原生NC标记及引脚电气类型。旧的“需要先修复导出器才能检查”结论不再适用于当前结果。

重新生成后暴露的电源冲突来自本项目的电气声明：Pi同一电源轨的多个触点被当成多个独立电源。现将5V、3.3V、GND各用一个触点代表其外部来源，其余同轨触点设为被动延续；没有删掉任何供电脚或改变铜连接。两颗缓冲器的原理图改为输入左、输出右、电源上、接地下，接地输入现在被原生ERC正确识别。原理图按接口、屏幕接头、缓冲和供电四个功能区自动排布，不手工定位坐标。

15项外壳/紧固件BOM派生记录已与当前零件核对。编译器只生成电气连接，实际铜由正式布线流程处理；没有降低线宽、间隙、电流要求或检查严重度。

## 本轮实际结果

| 检查 | 结果 |
|---|---|
| 正式PCB布线/制造规则检查 | 0错误、0阻断警告、0未连接 |
| 完整原生KiCad原理图ERC | 0错误、447条警告 |
| 原生板级DRC | 0错误、0未连接；13条库副本一致性警告 |
| 原生原理图与编译电路网表 | 32个器件、25个网络、132个连接端子一致 |
| 原生PCB端子焊盘网络 | 156个源端子逐一对应，无差异 |
| 明确NC | 24个原生NC标记，且未并入其他端子的网络 |
| 关键器件/接口端子 | 70项独立预期均满足 |
| 成品板与钻孔 | 四层、内外1oz、0.8mm；39个0.6/0.3mm过孔、40个1.1mm镀孔、2个2.2mm非镀孔 |
| 生产发布 | fabrication、assembly、mechanical三部分均生成 |

原生原理图的447条警告由323条端点不在网格、79条符号库提示、43条未连接线端和2条局部/全局同名标签提示构成。没有关闭这些检查；另外以原生KiCad导出的完整XML网表核对全部25个网络，确认这些警告没有造成器件端子的断连或跨网连接。不能将本轮描述成所有检查零警告。

源码编译器仍提示没有图纸页定义及在线补充资料服务抓取失败。本轮采用完整平面原理图，并核对了显式声明的供电、接地、方向和NC元数据，未将在线自动补充结果当作证据。GND自动桥接的小区域提示已结合In1.Cu和已有Pi镀孔检查；最终板级检查没有孤岛或未连接错误。外购件的设计证据已经确定，BOM中的required_user_evidence留空表示没有待补的设计事实，仍由用户自行采购；运行时对此的提示不等于引脚或封装未知。

## 复查与装配边界

audit-electrical.py只读核对源连接、原生PCB、原生原理图XML网表及ERC报告；electrical-review.json绑定本轮构建和发布。原始对照电路取自已提交的旧发布记录，即使发布工具清理旧输出，也可从Git读取，不手工恢复或改写制造文件。

已经查看当前原理图、PCB正反面、两层内铜、发布后的正反面Gerber预览及3D装配图。与外壳现有导入版本比较，板框、板厚、孔位及32个器件的放置/包络相同，本次无需因电气声明变化重做外壳。

手工装配意图保持；JLC贴片BOM/CPL只有表头，不是自焊采购清单。屏幕原排线接插、实际焊接质量、电源波形、COM持续反转、驱动和上下电时序、压降及温升仍须样机验证。数字检查通过不代替这些实测。
