c3ll256/rp-compute/(list of files, drawings)

Other design files:
design/handheld_computer/pcb-fit-check.json
design/handheld_computer/pcb-sync-handoff-review.json
