c3ll256/rp-compute/(commit log)

2026-09-20 docs(hardware): document verified candidates and power tradeoff
2026-09-21 feat(hardware): adopt 500mA USB power branch and track pack evidence
2026-09-21 docs(hardware): record user selected 3.7V battery type
2026-09-21 feat(hardware): target non-Zero compute and 3300mAh Li-ion battery
2026-09-21 feat(hardware): adopt Raspberry Pi 4B and native USB host
2026-09-21 feat(product): simplify Pi baseboard to power and display
2026-09-21 feat(hardware): shortlist GPIO dock protection and battery candidates
2026-09-21 feat(hardware): apply baseboard-only power and Pi port interlock
2026-09-21 feat(hardware): define user battery interface and complete functional selection
2026-09-21 feat(cad): create styling-first handheld enclosure and STEP handoff
2026-09-21 fix(cad): replace shallow wedge with raised screen housing
2026-09-22 fix(cad): lower screen housing angle to 13 degrees
2026-09-22 feat(cad): relocate ports around real Pi 4B geometry
2026-09-22 fix(cad): lower screen front rise to 1mm
2026-09-22 feat(cad): add LCD locating pocket and FPC entry relief
2026-09-23 feat(cad): add display rear retention and FPC routing
2026-09-23 build(cad): include validated STEP handoff
2026-09-23 fix(cad): tighten enclosure IO apertures
2026-09-23 fix(bom): refresh verified part identities
2026-09-23 feat(cad): add replaceable front GPIO module interface
2026-09-23 chore(pcb): establish previewable baseboard scaffold
2026-09-23 feat(pcb): define integrated baseboard interface draft
2026-09-23 fix(pcb): strap Sharp display external COM mode
2026-09-23 feat(pcb): draft integrated power and display circuits
2026-09-23 feat(pcb): integrate MCU interlock and module power
2026-09-24 fix(pcb): bind main switch pads and restore output connectivity
2026-09-24 fix(pcb): widen power pin fanouts and preserve current targets
2026-09-24 docs(product): define display and eight-pin GPIO variant
2026-09-25 feat(pcb): release display and eight-pin GPIO prototype
2026-09-25 fix(pcb): declare vertical GPIO connectors
2026-09-26 fix(pcb): use female expansion socket and screen-side FPC
2026-09-26 test(cad): verify lite PCB against screen and enclosure
2026-09-29 feat(pcb): compact display and expansion board layout
2026-09-29 docs(pcb): assess compact board enclosure interface conflicts
2026-09-30 feat(hardware): route compact board and update enclosure fit review
2026-09-30 fix(hardware): fit raised compact board to upper shell
2026-09-30 chore(manufacturing): retire superseded compact board exports
2026-10-04 fix(cad): secure bottom cover and remove side power button
    Add four bottom-cover fasteners and a locating rim, tighten native side-port openings, and restore the wall after removing the unused power button and cap. Include the current PCB enclosure fit reviews, updated product records, and verified STEP handoff through Git LFS.
2026-10-04 chore(cad): include verified enclosure STEP handoff
2026-10-08 fix(cad): separate removable expansion cover and close rear inlet slots
2026-11-04 fix(pcb): correct electrical checks and release production files
    Define explicit power, ground, signal and no-connect semantics and correct schematic electrical validation. Record native ERC, routed DRC, netlist parity and manufacturing file checks. Include matching requirements and BOM records with the reviewed production release.
2026-11-07 feat(pcb): release compact baseboard with generic sockets and JLC assembly review
2026-11-07 feat(cad): lower screen pod 0.8mm for FPC bend zone and sync enclosure to baseboard release
